Samin12665/MM-SIDE/out/reports/interference.md

# Interference and motion study

_Generated by `cad/build.py --check`._

## Static (ride height, straight ahead)

- No interference > 1 mm³.

## Motion sweep (steering × front travel, rear travel)

| Steer (crank frac) | Front travel L/R | Rear travel L/R | ψL | ψR | Collisions |
|---|---|---|---:|---:|---|
| -1 | -12/-12 | -12/-12 | -19.5° | -25.9° | 110_WHEEL_FL∩110_TIE_ROD_FL 1 mm³ |
| -1 | +18/+18 | +18/+18 | -19.2° | -25.9° | 110_WHEEL_FL∩110_TIE_ROD_FL 5 mm³ |
| -1 | +18/-12 | +18/-12 | -19.2° | -25.9° | 110_WHEEL_FL∩110_TIE_ROD_FL 5 mm³ |
| +0 | -12/-12 | -12/-12 | +0.0° | -0.0° | none |
| +0 | +18/+18 | +18/+18 | -0.0° | +0.0° | none |
| +0 | +18/-12 | +18/-12 | -0.0° | -0.0° | none |
| +1 | -12/-12 | -12/-12 | +25.9° | +19.5° | 110_WHEEL_FR∩110_TIE_ROD_FR 1 mm³ |
| +1 | +18/+18 | +18/+18 | +25.9° | +19.2° | 110_WHEEL_FR∩110_TIE_ROD_FR 5 mm³ |
| +1 | +18/-12 | +18/-12 | +25.9° | +19.5° | 110_WHEEL_FR∩110_TIE_ROD_FR 1 mm³ |
