Samin12665/MM-SIDE/docs/04_engineering_calculations.md

# 04 — Preliminary Engineering Calculations

_Generated by `analysis/vehicle_calcs.py` from `cad/master/car_master.py`. Do not edit by hand._

## 4.1 Mass and centre of gravity

Printed-part masses are taken from the CAD volumes (`out/reports/part_volumes.json`) × material density × effective fill (walls + infill). Purchased masses are vendor typicals.

| Item | Mass (kg) | X | Y | Z |
|---|---:|---:|---:|---:|
| Rear gearmotors x2 | 0.430 | -150 | 0 | 42 |
| Battery 3S 5000 | 0.380 | 30 | 0 | 49 |
| Jetson Orin Nano dev kit | 0.250 | -20 | 0 | 114 |
| Depth camera D435i | 0.072 | 172 | 0 | 140 |
| Main camera | 0.004 | 178 | 0 | 168 |
| LiDAR A1M8 (optional) | 0.170 | -40 | 0 | 218 |
| Steering servo | 0.060 | 208 | 0 | 36 |
| Wheels+tyres x4 | 0.280 | 0 | 0 | 42 |
| Shocks x4 | 0.080 | 0 | 0 | 80 |
| Motor driver | 0.060 | 60 | 40 | 78 |
| DC-DC converters x3 | 0.085 | 60 | -40 | 78 |
| MCU + IMU + receiver | 0.045 | 0 | 0 | 102 |
| E-stop + fuses + switch | 0.090 | -90 | 0 | 110 |
| Wiring + connectors | 0.150 | 20 | 0 | 70 |
| Al longerons x2 | 0.046 | 10 | 0 | 77 |
| Fasteners, bearings, inserts | 0.160 | 20 | 0 | 55 |
| Printed 10_MAIN_CHASSIS (PETG-CF) | 0.282 | 2 | -0 | 44 |
| Printed 11_LOWER_SKID (PETG) | 0.053 | 0 | 0 | 26 |
| Printed 12_UPPER_ELECTRONICS_DECK (PETG) | 0.131 | 28 | -0 | 93 |
| Printed 61_BATTERY_DOOR_L (PETG) | 0.007 | 30 | 78 | 48 |
| Printed 61_BATTERY_DOOR_R (PETG) | 0.007 | 30 | -78 | 48 |
| Printed 20_FRONT_BULKHEAD (PA-CF) | 0.078 | 161 | -3 | 36 |
| Printed 24_FRONT_SHOCK_TOWER (PA-CF) | 0.054 | 142 | -0 | 72 |
| Printed 21_FRONT_KNUCKLE_L (PA-CF) | 0.003 | 152 | 109 | 42 |
| Printed 22_FRONT_KNUCKLE_R (PA-CF) | 0.003 | 152 | -109 | 42 |
| Printed 23_FRONT_LOWER_ARM_L (PA-CF) | 0.015 | 145 | 67 | 26 |
| Printed 23_FRONT_LOWER_ARM_R (PA-CF) | 0.015 | 145 | -67 | 26 |
| Printed 42_BELLCRANK_L (PA-CF) | 0.001 | 177 | 48 | 35 |
| Printed 42_BELLCRANK_R (PA-CF) | 0.001 | 177 | -48 | 35 |
| Printed 42_DRAG_LINK (PA-CF) | 0.002 | 162 | 0 | 45 |
| Printed 42_SERVO_LINK (PA-CF) | 0.001 | 175 | 0 | 48 |
| Printed 31_REAR_TRAILING_ARM_L (PA-CF) | 0.056 | -97 | 89 | 47 |
| Printed 31_REAR_TRAILING_ARM_R (PA-CF) | 0.056 | -97 | -89 | 47 |
| Printed 32_REAR_HEX_ADAPTER_L (PA-CF) | 0.002 | -150 | 114 | 42 |
| Printed 32_REAR_HEX_ADAPTER_R (PA-CF) | 0.002 | -150 | -114 | 42 |
| Printed 30_REAR_SHOCK_TOWER (PA-CF) | 0.079 | -104 | -0 | 107 |
| Printed 70_COMPUTE_MOUNT (PETG) | 0.027 | -14 | -0 | 98 |
| Printed 71_MOTOR_CONTROLLER_MOUNT (PETG) | 0.016 | -65 | 29 | 39 |
| Printed 72_POWER_MODULE_MOUNT (PETG) | 0.010 | -76 | -36 | 39 |
| Printed 73_FRONT_POWER_TRAY (PETG) | 0.015 | 82 | -0 | 39 |
| Printed 74_MCU_IMU_PLATE (PETG) | 0.032 | 92 | -3 | 99 |
| Printed 83_SENSOR_MAST (PETG-CF) | 0.044 | 157 | -0 | 150 |
| Printed 81_DEPTH_SENSOR_MOUNT (PETG) | 0.014 | 165 | 0 | 132 |
| Printed 80_CAMERA_MOUNT (PETG) | 0.002 | 167 | -0 | 170 |
| Printed 84_LIDAR_MAST (PETG-CF) | 0.062 | -41 | -0 | 168 |
| Printed 82_LIDAR_MOUNT (PETG) | 0.026 | -40 | 0 | 198 |
| Printed 90_FRONT_BUMPER (TPU) | 0.063 | 228 | -0 | 58 |
| Printed 91_REAR_BUMPER (TPU) | 0.071 | -232 | -0 | 64 |
| Printed 92_BODY_SIDE_SKIRT_L (PETG) | 0.012 | 23 | 80 | 97 |
| Printed 92_BODY_SIDE_SKIRT_R (PETG) | 0.012 | 23 | -80 | 97 |
| Printed 100_RAIL_CABLE_CLIP (PETG) | 0.001 | 0 | 71 | 80 |
| **Total (with LiDAR)** | **3.62** | **-3.9** | **-0.3** | **75.6** |

* Weight distribution front/rear: **49 / 51 %** (front corner 8.6 N, rear corner 9.1 N).
* CG height 76 mm; half-track 125 mm → static rollover threshold a_y = (T/2)/h = **1.65 g**. Tyre μ≈1.0 on concrete, so the car slides before it rolls.
* Design allowance: +15 % mass growth → 4.16 kg used for all load cases below.

## 4.2 Drivetrain (dual rear gearmotors, direct drive)

Motor: Pololu 37D 19:1 12 V with 64 CPR encoder (VERIFY datasheet: 530 rpm no-load, 8.5 kg·cm stall, 5.5 A stall at 12 V).

| Quantity | Value |
|---|---:|
| Wheel radius | 42.5 mm |
| No-load wheel speed at 11.1 V | 490 rpm |
| No-load vehicle speed | 2.18 m/s |
| Expected loaded top speed | **1.85 m/s (6.7 km/h)** |
| Stall torque per motor at 11.1 V | 0.77 N·m |
| Rolling resistance (Crr 0.03) | 1.22 N |
| Torque/motor for 2.0 m/s² on flat | 0.203 N·m (26 % stall) |
| Torque/motor to climb 15° | 0.250 N·m (33 % stall) |
| Traction-limited torque/rear wheel (μ 0.9) | 0.400 N·m |
| Encoder resolution at wheel | 64 × 19 = 1216 counts/rev → 0.220 mm/count |

Assessment: a 2 m/s top speed is deliberate — it keeps camera motion blur, LiDAR scan skew and stopping distance compatible with indoor SLAM and path-planning work. Hill climbing at 15° uses 33 % of stall torque, which is inside the gearmotor's intermittent envelope; continuous operation should stay below ~25 % stall. Traction limit (0.40 N·m) is below stall (0.77 N·m), so an uncontrolled full-throttle launch can spin the rear tyres and corrupt wheel odometry. Firmware must ramp-limit acceleration to ≤ 2 m/s² (0.20 N·m, 51 % of traction limit); the front AS5600 wheel encoders (non-driven wheels) provide an independent slip check.

Stopping distance from top speed at 3 m/s² (active braking by the H-bridge): **573 mm**.

Gearmotor output shaft (Ø6 mm D-shaft) under a 3 g bump: F = 31.4 N at 18 mm overhang → M = 565 N·mm, σ = 27 MPa (steel yield ≥ 350 MPa, SF > 9). Wheel hub is placed hard against the gearbox face to keep the overhang short.

## 4.3 Steering

* Layout: front-steer dual bellcranks on vertical M3 shoulder bolts, drag link, M3 turnbuckle tie rods (74.3 mm).
* Inner / outer lock: **26.0° / 19.5°** — Ackermann 102 % at lock, 91 % at mid-travel (100 % = ideal).
* Turning radius (rear-axle centre): **0.72 m**; kerb-to-kerb (outer front tyre) ≈ 1.02 m.
* Bump steer over -12…+18 mm: **0.02°** (tie-rod inner ball placed on the instant-centre line; hold crank height ±0.2 mm with shims).
* Static (parked) steering torque per kingpin, μ=1.0, r_eff = scrub 12 + patch 10 mm: 0.219 N·m.
* Required servo torque ≈ **0.44 N·m (4.5 kg·cm)**. Selected 20 kg·cm servo → safety factor **4.4**.
* Crank rotation to lock: 31.0° → servo throw ≈ ±28° (within standard ±45°).

## 4.4 Suspension

Shock: 1/10 oil shock, 80 mm extended, 22 mm stroke → usable 58…80 mm.

| Corner | Droop length | Ride length | Bump length | Stroke used | Motion ratio | In range |
|---|---:|---:|---:|---:|---:|---|
| Front | 76.6 | 69.5 | 59.4 | 17.2 | 0.57 | YES |
| Rear | 79.5 | 71.2 | 58.5 | 21.0 | 0.70 | YES |

* Front: corner mass 1.01 kg, target ride frequency 3.5 Hz → wheel rate 0.49 N/mm, **spring rate 1.49 N/mm** (MR 0.57), static sag 20.3 mm (set with preload collar so ride height = design).

* Rear: corner mass 1.07 kg, target ride frequency 3.5 Hz → wheel rate 0.52 N/mm, **spring rate 1.05 N/mm** (MR 0.70), static sag 20.3 mm (set with preload collar so ride height = design).

* Front camber change over full travel: -1.38° … -0.02°; half-track change ≤ 2.4 mm (low tyre scrub → clean odometry).
* Rear: trailing arm → zero camber and track change; wheelbase change at full bump 1.4 mm.

## 4.5 Structural load cases (per corner, design mass)

| Case | Front corner Fz (N) | Rear corner Fz (N) | Notes |
|---|---:|---:|---|
| Static | 9.9 | 10.5 | |
| Pothole / kerb drop (3 g) | 29.8 | 31.4 | |
| Drop from 300 mm onto tyres (≈5 g) | 49.7 | 52.3 | |

* Front lower arm, 5 g, load at ball 33 mm outboard of shock mount: M = 1639 N·mm, section 18×8 mm → σ = 8.5 MPa. PA-CF (Z-direction-free layup, printed flat) allowable ≈ 45 MPa → SF 5.3.
* Rear trailing arm, 5 g: M = 1883 N·mm at shock mount → σ = 1.3 MPa (beam 18×22 mm) → SF 34.7. Motor torque reaction (0.8 N·m stall) is carried by 6× M3 face bolts: shear per bolt 9 N.
* Chassis spine: 2 × 10×10×1 6063 tubes (I = 492 mm⁴ each) along the full tub (238 mm, rear-arm pivots → front bulkhead joint). Conservative case — whole 3 g vehicle load at mid-span on the rails alone, simply supported: deflection 0.51 mm, stress 37.0 MPa vs 6063-T5 yield 145 MPa. The 55 mm deep printed tub walls and the bolted deck act in parallel and carry most of this in practice.
* Front bulkhead is a cantilever off the tub front wall (6× M3 into inserts + flange bearing). A 5 g front-corner load on both sides (99 N) at ≈ 35 mm from the flange gives ≈ 3.5 N·m → ≈ 70 N tension in the upper bolt pair, far below the ≈ 800 N pull-out of an M3 insert in PETG-CF.
* Torsion is carried by the closed box formed by skid + tub walls + rails + upper deck (deck screwed at 8 points).

## 4.6 Power budget and runtime

| Load | Power (W) |
|---|---:|
| Jetson Orin Nano (MAXN Super, typical) | 15.0 |
| Drive motors (2 × 0.9 A avg @ 11.1 V) | 20.0 |
| Steering servo avg | 2.0 |
| D435i | 2.0 |
| RPLIDAR A1 | 2.5 |
| MCU, IMU, receiver, encoders | 1.0 |
| DC-DC losses (~10 %) | 4.0 |
| **Total** | **46.5** |

Usable energy 3S 5000 mAh at 80 % DoD = 44.4 Wh → runtime ≈ **57 min** mixed driving; ≈ 93 min parked (compute + sensors only).

Peak current: 2 × stall 5.1 A + servo 3 A + electronics 2.5 A ≈ 16 A → main fuse 15 A slow-blow, motor-branch fuse 10 A, compute branch 5 A. Wire: 14 AWG battery–fuse–E-stop, 18 AWG motor, 22–24 AWG signal.

## 4.7 Design targets vs results

| Requirement | Target | Result |
|---|---|---|
| Mass (incl. optional LiDAR) | ≤ 3.6 kg | 3.62 kg |
| Top speed | 1.5–2.5 m/s | 1.85 m/s |
| Turning radius | ≤ 0.8 m | 0.72 m |
| Ground clearance | ≥ 25 mm under main tub | 25 mm tub, 18 mm front bulkhead (static). At full front compression the bulkhead underside is the bump stop, as on most 1/10 cars; fit 3 mm internal shock spacers if ground contact is unwanted |
| Wheel travel | ≥ 25 mm | 30 mm |
| Rollover threshold | ≥ 1.2 g | 1.65 g |
| Runtime | ≥ 30 min | 57 min |
| Camera height | 120–200 mm | 168 mm |
