Samin12665/MM-SIDE/out/renders/ASM_CAR_COMPLETE_exploded.png

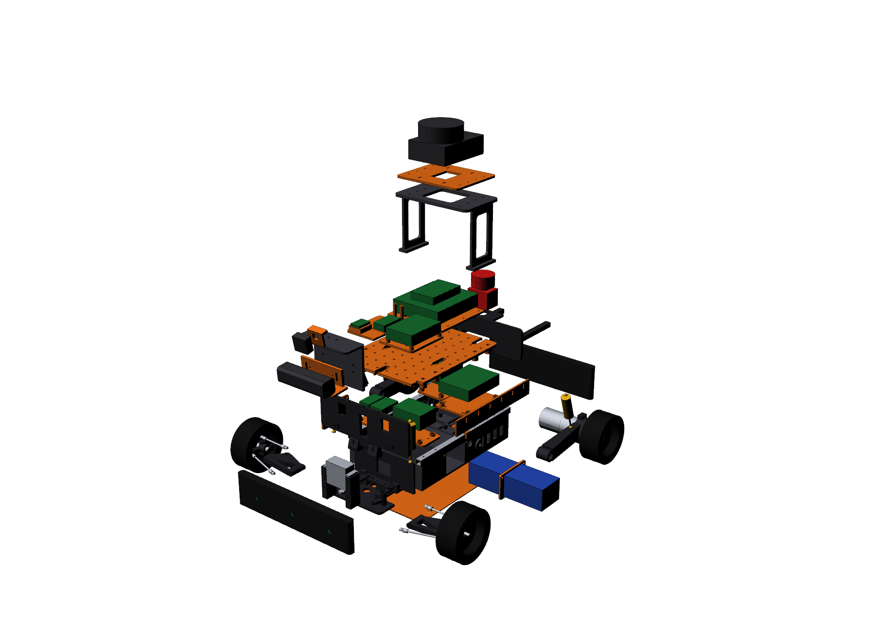
out/renders/ASM_CAR_COMPLETE_exploded.png
