Samin12665/MM-SIDE/out/renders/ASM_CAR_COMPLETE_iso_rear.png

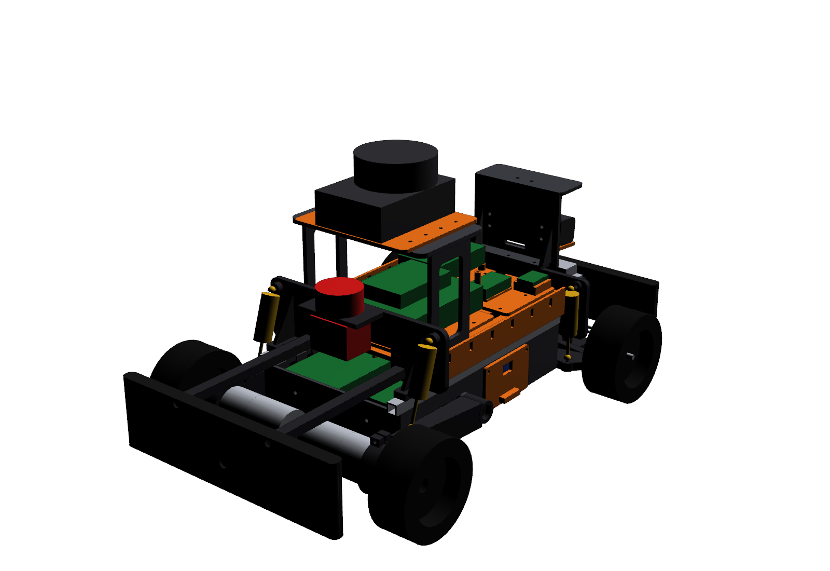
out/renders/ASM_CAR_COMPLETE_iso_rear.png
