Samin12665/MM-SIDE/out/renders/CHASSIS_LAYOUT_top.png

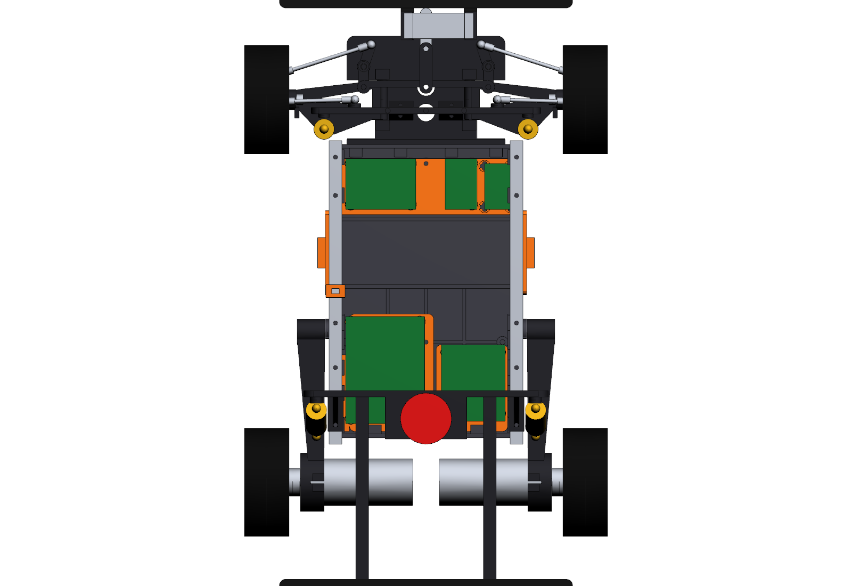
out/renders/CHASSIS_LAYOUT_top.png
