Samin12665/MM-SIDE/out/renders/FRONT_view.png

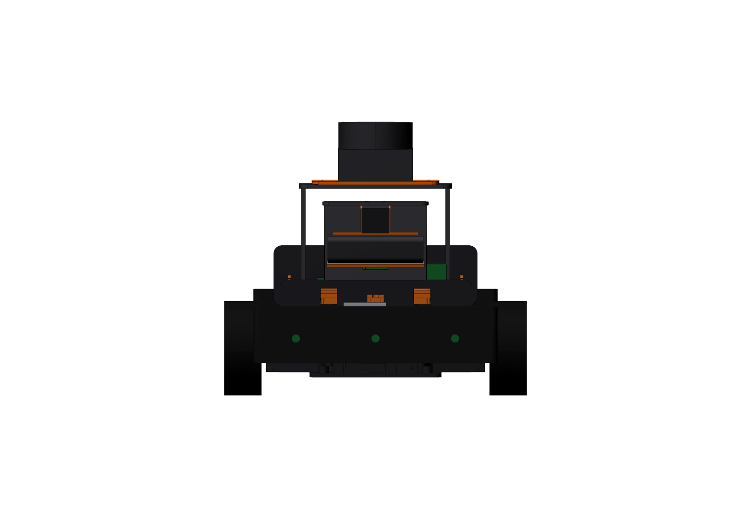
out/renders/FRONT_view.png
