Samin12665/MM-SIDE/out/renders/SENSOR_LAYOUT_side.png

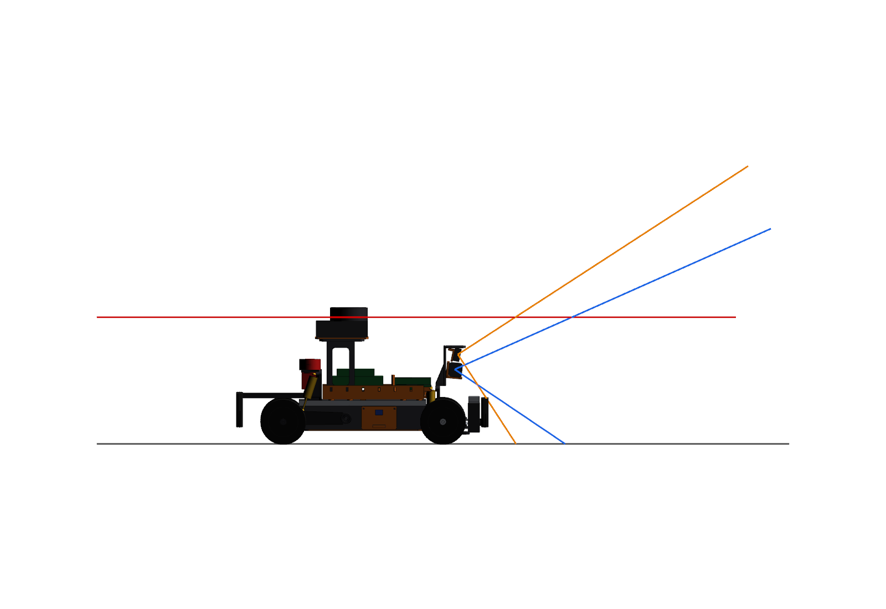
out/renders/SENSOR_LAYOUT_side.png
