Samin12665/MM-SIDE/out/renders/STEERING_full_lock_top.png

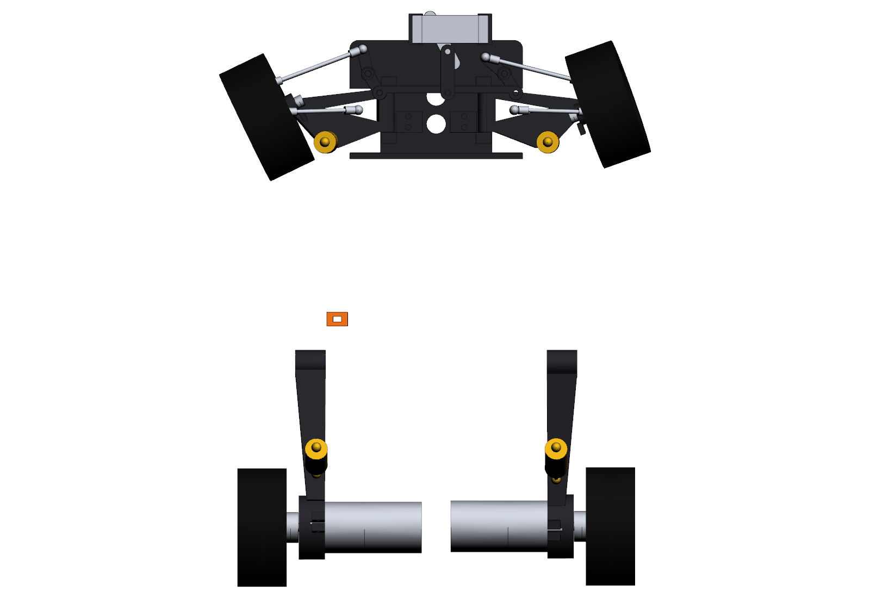
out/renders/STEERING_full_lock_top.png
