Samin12665/MM-SIDE/bom/print_list.csv

part | qty | material | orientation | layer_mm | walls | infill | top/bottom | supports | inserts | post_processing | print_bbox_mm | est_mass_g | stl
10_MAIN_CHASSIS | 1 | PETG-CF or ASA | floor on bed (as modelled); brim 5 mm | 0.20 | 4 | 30% gyroid | 5/5 | none | 38x M3 + 2x M5 | deburr; install heat-set inserts at 245 °C | 230.0x158.0x45.0 | 282 | out/stl/10_MAIN_CHASSIS.stl
11_LOWER_SKID | 1 | PETG | flat | 0.20 | 3 | 20% gyroid | 4/4 | none | — | install heat-set inserts at 240 °C | 226.0x144.0x2.0 | 53 | out/stl/11_LOWER_SKID.stl
12_UPPER_ELECTRONICS_DECK | 1 | PETG | top face on bed, ribs up | 0.20 | 3 | 20% gyroid | 4/4 | none | 24x M3 (fit only the grid nodes you use; 70 available) | install heat-set inserts at 240 °C | 208.0x160.0x14.0 | 131 | out/stl/12_UPPER_ELECTRONICS_DECK.stl
61_BATTERY_DOOR_L | 1 | PETG | outer face on bed | 0.20 | 3 | 20% gyroid | 4/4 | none | — | install heat-set inserts at 240 °C | 66.0x43.0x9.0 | 7 | out/stl/61_BATTERY_DOOR_L.stl
61_BATTERY_DOOR_R | 1 | PETG | outer face on bed | 0.20 | 3 | 20% gyroid | 4/4 | none | — | install heat-set inserts at 240 °C | 66.0x43.0x9.0 | 7 | out/stl/61_BATTERY_DOOR_R.stl
20_FRONT_BULKHEAD | 1 | PA-CF (PETG-CF acceptable) | floor on bed; supports only under servo-pillar insert bosses if the slicer flags them | 0.20 | 5 | 40% gyroid | 6/6 | none unless noted | 12x M3 | dry filament 8 h @ 80 °C before printing; anneal optional 80 °C 4 h; ream bearing seats, hinge holes Ø3.0/3.2 drill | 104.0x124.0x58.0 | 78 | out/stl/20_FRONT_BULKHEAD.stl
24_FRONT_SHOCK_TOWER | 1 | PA-CF | rear face on bed (plate flat) — layers in the load plane | 0.20 | 5 | 40% gyroid | 6/6 | none unless noted | 7x M3 | dry filament 8 h @ 80 °C before printing; anneal optional 80 °C 4 h; ream bearing seats, hinge holes Ø3.0/3.2 drill | 79.0x180.0x15.0 | 54 | out/stl/24_FRONT_SHOCK_TOWER.stl
21_FRONT_KNUCKLE_L | 1 | PA-CF | bearing axis vertical, inboard face on bed | 0.20 | 5 | 40% gyroid | 6/6 | none unless noted | 3x M3x4 short | dry filament 8 h @ 80 °C before printing; anneal optional 80 °C 4 h; ream bearing seats, hinge holes Ø3.0/3.2 drill | 39.4x22.3x19.6 | 3 | out/stl/21_FRONT_KNUCKLE_L.stl
22_FRONT_KNUCKLE_R | 1 | PA-CF | bearing axis vertical, inboard face on bed | 0.20 | 5 | 40% gyroid | 6/6 | none unless noted | 3x M3x4 short | dry filament 8 h @ 80 °C before printing; anneal optional 80 °C 4 h; ream bearing seats, hinge holes Ø3.0/3.2 drill | 39.4x22.3x19.6 | 3 | out/stl/22_FRONT_KNUCKLE_R.stl
23_FRONT_LOWER_ARM_L | 1 | PA-CF | flat (as modelled) | 0.20 | 5 | 40% gyroid | 6/6 | none unless noted | 2x M3 | dry filament 8 h @ 80 °C before printing; anneal optional 80 °C 4 h; ream bearing seats, hinge holes Ø3.0/3.2 drill | 44.5x73.3x8.6 | 15 | out/stl/23_FRONT_LOWER_ARM_L.stl
23_FRONT_LOWER_ARM_R | 1 | PA-CF | flat (as modelled) | 0.20 | 5 | 40% gyroid | 6/6 | none unless noted | 2x M3 | dry filament 8 h @ 80 °C before printing; anneal optional 80 °C 4 h; ream bearing seats, hinge holes Ø3.0/3.2 drill | 44.5x73.3x8.6 | 15 | out/stl/23_FRONT_LOWER_ARM_R.stl
42_BELLCRANK_L | 1 | PA-CF | flat, tie-rod arm down | 0.20 | 5 | 40% gyroid | 6/6 | none unless noted | 2x M3 | dry filament 8 h @ 80 °C before printing; anneal optional 80 °C 4 h; ream bearing seats, hinge holes Ø3.0/3.2 drill | 41.1x14.7x14.5 | 1 | out/stl/42_BELLCRANK_L.stl
42_BELLCRANK_R | 1 | PA-CF | flat, tie-rod arm down | 0.20 | 5 | 40% gyroid | 6/6 | none unless noted | 2x M3 | dry filament 8 h @ 80 °C before printing; anneal optional 80 °C 4 h; ream bearing seats, hinge holes Ø3.0/3.2 drill | 41.1x14.7x14.5 | 1 | out/stl/42_BELLCRANK_R.stl
42_DRAG_LINK | 1 | PA-CF | flat | 0.20 | 5 | 40% gyroid | 6/6 | none unless noted | 1x M3 | dry filament 8 h @ 80 °C before printing; anneal optional 80 °C 4 h; ream bearing seats, hinge holes Ø3.0/3.2 drill | 10.0x107.8x3.0 | 2 | out/stl/42_DRAG_LINK.stl
42_SERVO_LINK | 1 | PA-CF | flat | 0.20 | 5 | 40% gyroid | 6/6 | none unless noted | — | dry filament 8 h @ 80 °C before printing; anneal optional 80 °C 4 h; ream bearing seats, hinge holes Ø3.0/3.2 drill | 40.0x10.0x3.0 | 1 | out/stl/42_SERVO_LINK.stl
31_REAR_TRAILING_ARM_L | 1 | PA-CF | inboard face on bed: motor cup + pivot bores vertical, beam layers carry bending | 0.20 | 5 | 40% gyroid | 6/6 | none unless noted | 1x M3 | dry filament 8 h @ 80 °C before printing; anneal optional 80 °C 4 h; ream bearing seats, hinge holes Ø3.0/3.2 drill | 151.0x52.0x26.0 | 56 | out/stl/31_REAR_TRAILING_ARM_L.stl
31_REAR_TRAILING_ARM_R | 1 | PA-CF | inboard face on bed | 0.20 | 5 | 40% gyroid | 6/6 | none unless noted | 1x M3 | dry filament 8 h @ 80 °C before printing; anneal optional 80 °C 4 h; ream bearing seats, hinge holes Ø3.0/3.2 drill | 151.0x52.0x26.0 | 56 | out/stl/31_REAR_TRAILING_ARM_R.stl
32_REAR_HEX_ADAPTER_L | 1 | PA-CF | flange on bed | 0.20 | 5 | 40% gyroid | 6/6 | none unless noted | 1x M3x4 short | dry filament 8 h @ 80 °C before printing; anneal optional 80 °C 4 h; ream bearing seats, hinge holes Ø3.0/3.2 drill | 22.0x22.0x10.0 | 2 | out/stl/32_REAR_HEX_ADAPTER_L.stl
32_REAR_HEX_ADAPTER_R | 1 | PA-CF | flange on bed | 0.20 | 5 | 40% gyroid | 6/6 | none unless noted | 1x M3x4 short | dry filament 8 h @ 80 °C before printing; anneal optional 80 °C 4 h; ream bearing seats, hinge holes Ø3.0/3.2 drill | 22.0x22.0x10.0 | 2 | out/stl/32_REAR_HEX_ADAPTER_R.stl
30_REAR_SHOCK_TOWER | 1 | PA-CF (PETG-CF acceptable) | front face on bed (plate flat); tree supports under E-stop shelf + hoop arms | 0.20 | 5 | 40% gyroid | 6/6 | none unless noted | 4x M3 | dry filament 8 h @ 80 °C before printing; anneal optional 80 °C 4 h; ream bearing seats, hinge holes Ø3.0/3.2 drill | 56.2x192.0x148.0 | 79 | out/stl/30_REAR_SHOCK_TOWER.stl
70_COMPUTE_MOUNT | 1 | PETG | flat | 0.20 | 3 | 20% gyroid | 4/4 | none | — | install heat-set inserts at 240 °C | 112.0x112.0x9.0 | 27 | out/stl/70_COMPUTE_MOUNT.stl
71_MOTOR_CONTROLLER_MOUNT | 1 | PETG | flat | 0.20 | 3 | 20% gyroid | 4/4 | none | — | install heat-set inserts at 240 °C | 92.0x72.0x9.0 | 16 | out/stl/71_MOTOR_CONTROLLER_MOUNT.stl
72_POWER_MODULE_MOUNT | 1 | PETG | flat | 0.20 | 3 | 20% gyroid | 4/4 | none | — | install heat-set inserts at 240 °C | 68.0x56.0x9.0 | 10 | out/stl/72_POWER_MODULE_MOUNT.stl
73_FRONT_POWER_TRAY | 1 | PETG | flat | 0.20 | 3 | 20% gyroid | 4/4 | none | — | install heat-set inserts at 240 °C | 44.5x140.5x7.0 | 15 | out/stl/73_FRONT_POWER_TRAY.stl
74_MCU_IMU_PLATE | 1 | PETG | flat | 0.20 | 3 | 20% gyroid | 4/4 | none | — | install heat-set inserts at 240 °C | 78.0x132.0x33.0 | 32 | out/stl/74_MCU_IMU_PLATE.stl
83_SENSOR_MAST | 1 | PETG-CF | mast plate flat (back on bed) | 0.20 | 4 | 30% gyroid | 5/5 | none | 6x M3 | deburr; install heat-set inserts at 245 °C | 74.0x100.0x55.5 | 44 | out/stl/83_SENSOR_MAST.stl
81_DEPTH_SENSOR_MOUNT | 1 | PETG | mounting face on bed | 0.20 | 3 | 20% gyroid | 4/4 | none | — | install heat-set inserts at 240 °C | 32.5x92.0x30.1 | 14 | out/stl/81_DEPTH_SENSOR_MOUNT.stl
80_CAMERA_MOUNT | 1 | PETG | as modelled (support under arm) | 0.20 | 3 | 20% gyroid | 4/4 | none | — | install heat-set inserts at 240 °C | 12.6x28.0x25.0 | 2 | out/stl/80_CAMERA_MOUNT.stl
84_LIDAR_MAST | 1 | PETG-CF | top plate on bed, frames up | 0.20 | 4 | 30% gyroid | 5/5 | none | 8x M3 | deburr; install heat-set inserts at 245 °C | 84.0x152.0x101.0 | 62 | out/stl/84_LIDAR_MAST.stl
82_LIDAR_MOUNT | 1 | PETG | flat | 0.20 | 3 | 20% gyroid | 4/4 | none | — | install heat-set inserts at 240 °C | 100.0x120.0x3.0 | 26 | out/stl/82_LIDAR_MOUNT.stl
90_FRONT_BUMPER | 1 | TPU 95A | upright, webs vertical | 0.24 | 3 | 15% gyroid | 3/3 | none | — | print slow (25 mm/s); no inserts in TPU (screws pass through) | 16.0x230.0x53.0 | 63 | out/stl/90_FRONT_BUMPER.stl
91_REAR_BUMPER | 1 | TPU 95A | upright, webs vertical | 0.24 | 3 | 15% gyroid | 3/3 | none | — | print slow (25 mm/s); no inserts in TPU (screws pass through) | 12.0x230.0x63.0 | 71 | out/stl/91_REAR_BUMPER.stl
92_BODY_SIDE_SKIRT_L | 1 | PETG | outer face on bed | 0.20 | 3 | 20% gyroid | 4/4 | none | — | install heat-set inserts at 240 °C | 190.0x26.0x10.5 | 12 | out/stl/92_BODY_SIDE_SKIRT_L.stl
92_BODY_SIDE_SKIRT_R | 1 | PETG | outer face on bed | 0.20 | 3 | 20% gyroid | 4/4 | none | — | install heat-set inserts at 240 °C | 190.0x26.0x10.5 | 12 | out/stl/92_BODY_SIDE_SKIRT_R.stl
100_RAIL_CABLE_CLIP | 12 | PETG | saddle on bed | 0.20 | 3 | 20% gyroid | 4/4 | none | — | install heat-set inserts at 240 °C | 10.0x15.0x10.5 | 7 | out/stl/100_RAIL_CABLE_CLIP.stl
