Samin12665/MM-SIDE/out/step/ASM_SENSOR_SYSTEM.step

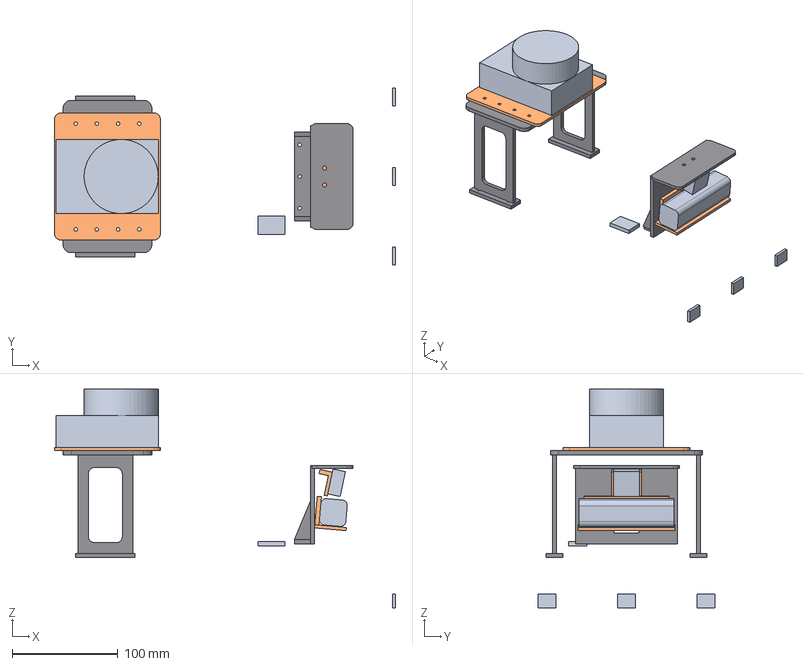
[picture p8: CAD file, 2026-09-28]
out/step/ASM_SENSOR_SYSTEM.step
322.0 x 167.0 x 206.5 mm
83_SENSOR_MAST
81_DEPTH_SENSOR_MOUNT
80_CAMERA_MOUNT
84_LIDAR_MAST
82_LIDAR_MOUNT
110_REALSENSE_D435I
110_CAMERA_IMX219
110_RPLIDAR_A1
110_IMU_BNO085
110_TOF_VL53L1X_0
110_TOF_VL53L1X_1
110_TOF_VL53L1X_2
