Samin12665/MM-SIDE/out/step/parts/10_MAIN_CHASSIS.step

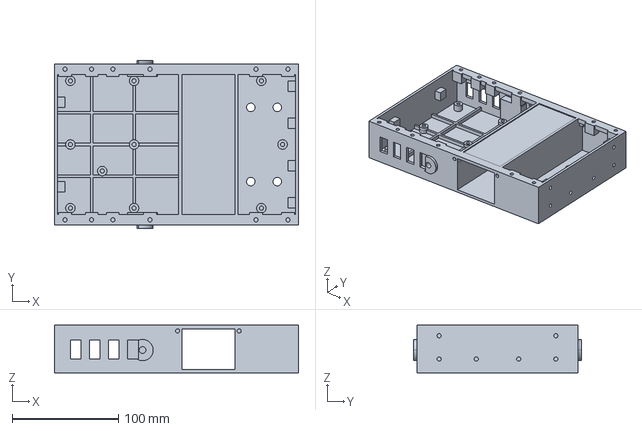
[picture p9: CAD file, 2026-09-28]
out/step/parts/10_MAIN_CHASSIS.step
230.0 x 158.0 x 45.0 mm
