Samin12665/MM-SIDE/out/step/ASM_REAR_SUSPENSION.step

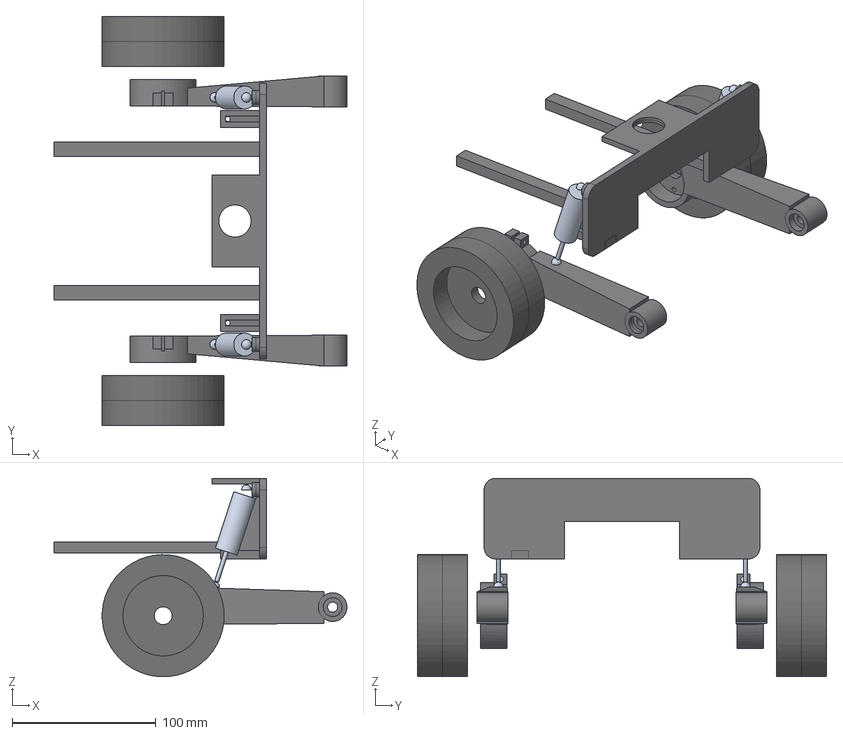
[picture p10: CAD file, 2026-09-28]
out/step/ASM_REAR_SUSPENSION.step
204.0 x 285.0 x 138.2 mm
30_REAR_SHOCK_TOWER
31_REAR_TRAILING_ARM_L
110_WHEEL_RL
110_SHOCK_RL
31_REAR_TRAILING_ARM_R
110_WHEEL_RR
110_SHOCK_RR
