Samin12665/MM-SIDE/out/step/ASM_CHASSIS.step

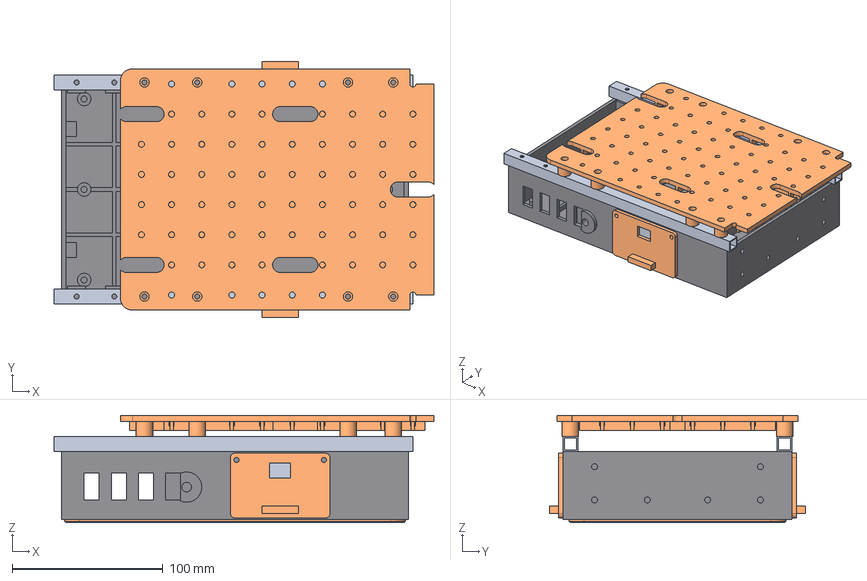
[picture p11: CAD file, 2026-09-28]
out/step/ASM_CHASSIS.step
252.0 x 170.0 x 71.0 mm
10_MAIN_CHASSIS
11_LOWER_SKID
12_UPPER_ELECTRONICS_DECK
61_BATTERY_DOOR_L
61_BATTERY_DOOR_R
110_BATTERY_3S_5000
110_AL_RAIL_10x10_L
110_AL_RAIL_10x10_R
