Samin12665/MM-SIDE/out/step/ASM_STEERING.step

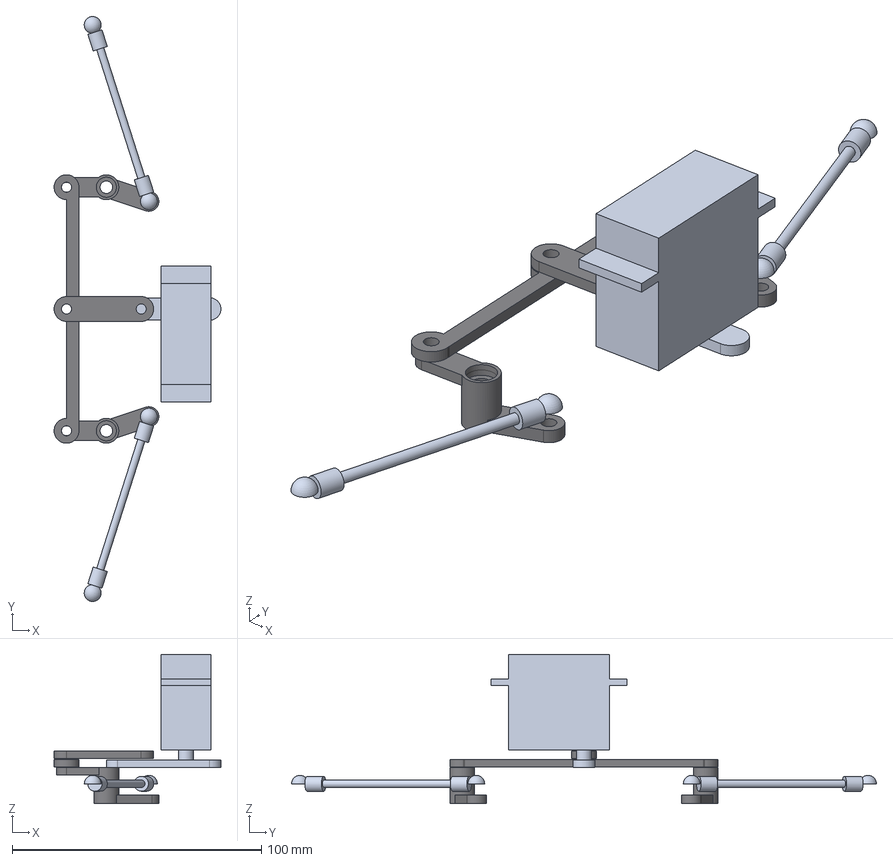
[picture p12: CAD file, 2026-09-28]
out/step/ASM_STEERING.step
67.0 x 234.9 x 60.0 mm
42_BELLCRANK_L
42_BELLCRANK_R
42_DRAG_LINK
42_SERVO_LINK
110_TIE_ROD_FL
110_TIE_ROD_FR
110_STEERING_SERVO
