Samin12665/MM-SIDE/out/step/ASM_CAR_COMPLETE.step

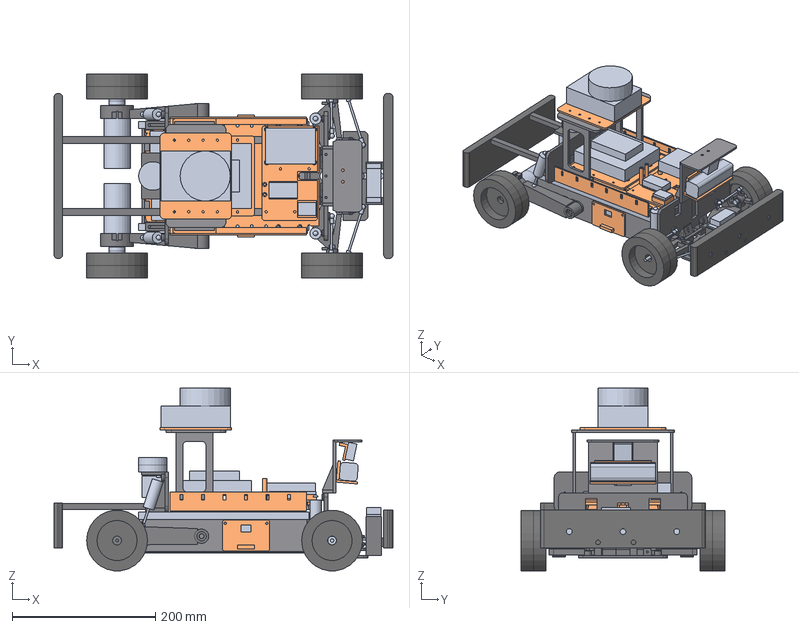
[picture p13: CAD file, 2026-09-28]
out/step/ASM_CAR_COMPLETE.step
473.0 x 285.0 x 254.7 mm
10_MAIN_CHASSIS
11_LOWER_SKID
12_UPPER_ELECTRONICS_DECK
61_BATTERY_DOOR_L
61_BATTERY_DOOR_R
20_FRONT_BULKHEAD
24_FRONT_SHOCK_TOWER
30_REAR_SHOCK_TOWER
70_COMPUTE_MOUNT
71_MOTOR_CONTROLLER_MOUNT
72_POWER_MODULE_MOUNT
73_FRONT_POWER_TRAY
74_MCU_IMU_PLATE
83_SENSOR_MAST
81_DEPTH_SENSOR_MOUNT
80_CAMERA_MOUNT
84_LIDAR_MAST
82_LIDAR_MOUNT
90_FRONT_BUMPER
91_REAR_BUMPER
92_BODY_SIDE_SKIRT_L
92_BODY_SIDE_SKIRT_R
100_RAIL_CABLE_CLIP
42_BELLCRANK_L
42_BELLCRANK_R
42_DRAG_LINK
42_SERVO_LINK
23_FRONT_LOWER_ARM_L
21_FRONT_KNUCKLE_L
110_WHEEL_FL
110_HEX12_FL
110_AXLE_M5x35_FL
110_BRG_685_FL1
110_BRG_685_FL2
110_SHOCK_FL
110_CAMBER_LINK_FL
110_TIE_ROD_FL
23_FRONT_LOWER_ARM_R
22_FRONT_KNUCKLE_R
110_WHEEL_FR
110_HEX12_FR
110_AXLE_M5x35_FR
110_BRG_685_FR1
110_BRG_685_FR2
110_SHOCK_FR
110_CAMBER_LINK_FR
110_TIE_ROD_FR
31_REAR_TRAILING_ARM_L
110_GEARMOTOR_37D_L
110_POLOLU_HUB_L
32_REAR_HEX_ADAPTER_L
110_WHEEL_RL
110_SHOCK_RL
31_REAR_TRAILING_ARM_R
110_GEARMOTOR_37D_R
110_POLOLU_HUB_R
32_REAR_HEX_ADAPTER_R
110_WHEEL_RR
110_SHOCK_RR
110_BATTERY_3S_5000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
