Samin12665/MM-SIDE/out/step/ASM_ELECTRONICS.step

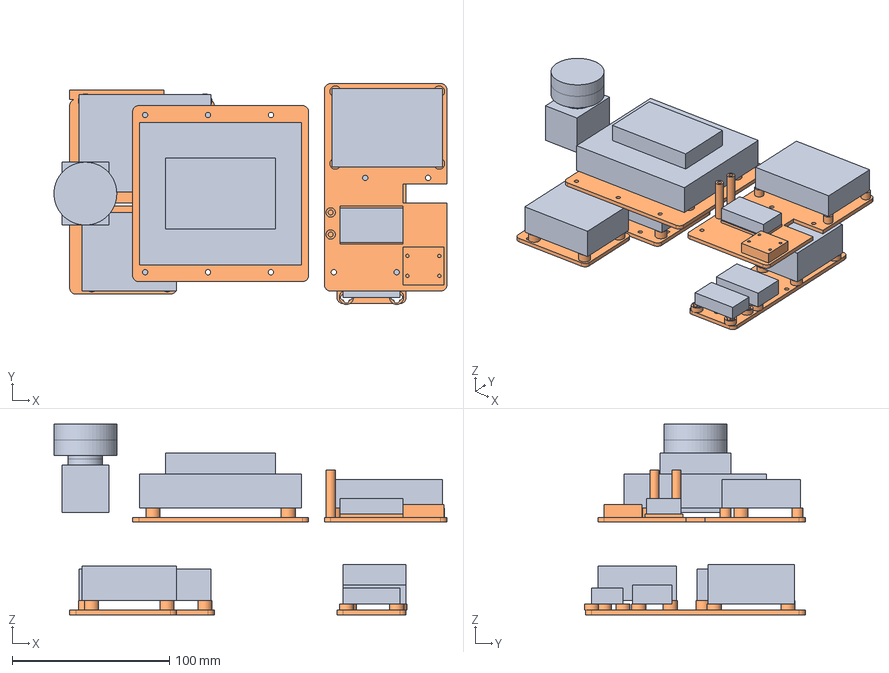
[picture p14: CAD file, 2026-09-28]
out/step/ASM_ELECTRONICS.step
250.0 x 140.5 x 121.2 mm
70_COMPUTE_MOUNT
71_MOTOR_CONTROLLER_MOUNT
72_POWER_MODULE_MOUNT
73_FRONT_POWER_TRAY
74_MCU_IMU_PLATE
110_JETSON_ORIN_NANO
110_ESTOP_22MM
110_MOTOR_DRIVER_MDD10A
110_DCDC_19V
110_FUSE_BLOCK
110_BEC_6V
110_BUCK_5V
110_TEENSY_CARRIER
110_RC_RECEIVER
