Samin12665/MM-SIDE/out/step/ASM_FRONT_SUSPENSION.step

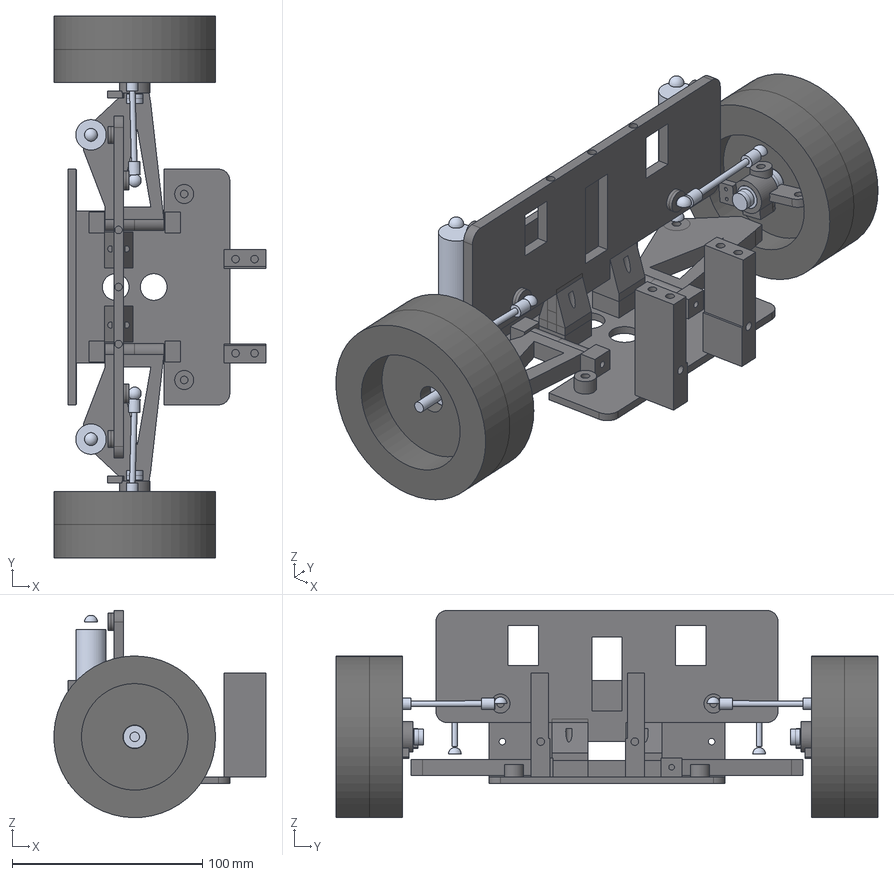
[picture p15: CAD file, 2026-09-28]
out/step/ASM_FRONT_SUSPENSION.step
111.4 x 285.0 x 109.0 mm
20_FRONT_BULKHEAD
24_FRONT_SHOCK_TOWER
23_FRONT_LOWER_ARM_L
21_FRONT_KNUCKLE_L
110_WHEEL_FL
110_HEX12_FL
110_AXLE_M5x35_FL
110_BRG_685_FL1
110_BRG_685_FL2
110_SHOCK_FL
110_CAMBER_LINK_FL
23_FRONT_LOWER_ARM_R
22_FRONT_KNUCKLE_R
110_WHEEL_FR
110_HEX12_FR
110_AXLE_M5x35_FR
110_BRG_685_FR1
110_BRG_685_FR2
110_SHOCK_FR
110_CAMBER_LINK_FR
