Samin12665/MM-SIDE/out/step/ASM_DRIVETRAIN.step

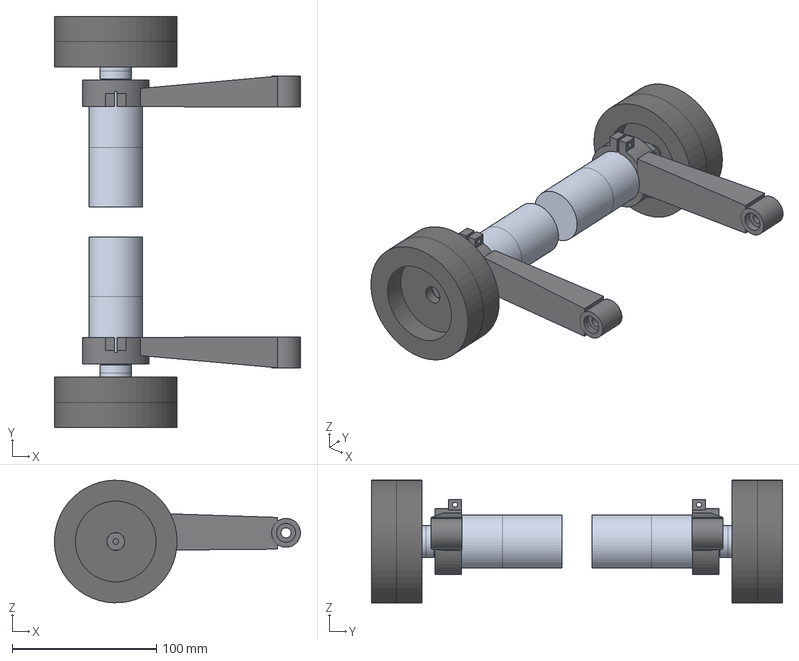
[picture p16: CAD file, 2026-09-28]
out/step/ASM_DRIVETRAIN.step
170.4 x 285.0 x 85.0 mm
31_REAR_TRAILING_ARM_L
110_GEARMOTOR_37D_L
110_POLOLU_HUB_L
32_REAR_HEX_ADAPTER_L
110_WHEEL_RL
31_REAR_TRAILING_ARM_R
110_GEARMOTOR_37D_R
110_POLOLU_HUB_R
32_REAR_HEX_ADAPTER_R
110_WHEEL_RR
