Samin12665/MM-SIDE/out/step/parts/81_DEPTH_SENSOR_MOUNT.step

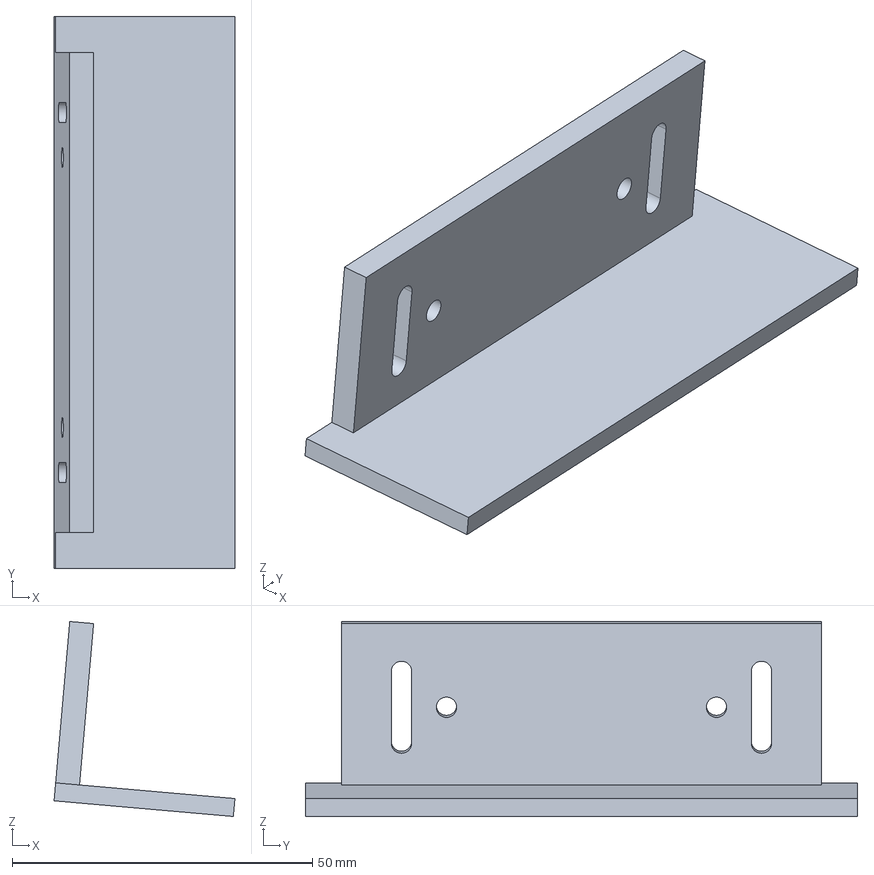
[picture p17: CAD file, 2026-09-28]
out/step/parts/81_DEPTH_SENSOR_MOUNT.step
30.1 x 92.0 x 32.5 mm
