Samin12665/MM-SIDE/out/step/parts/22_FRONT_CHUB_R.step

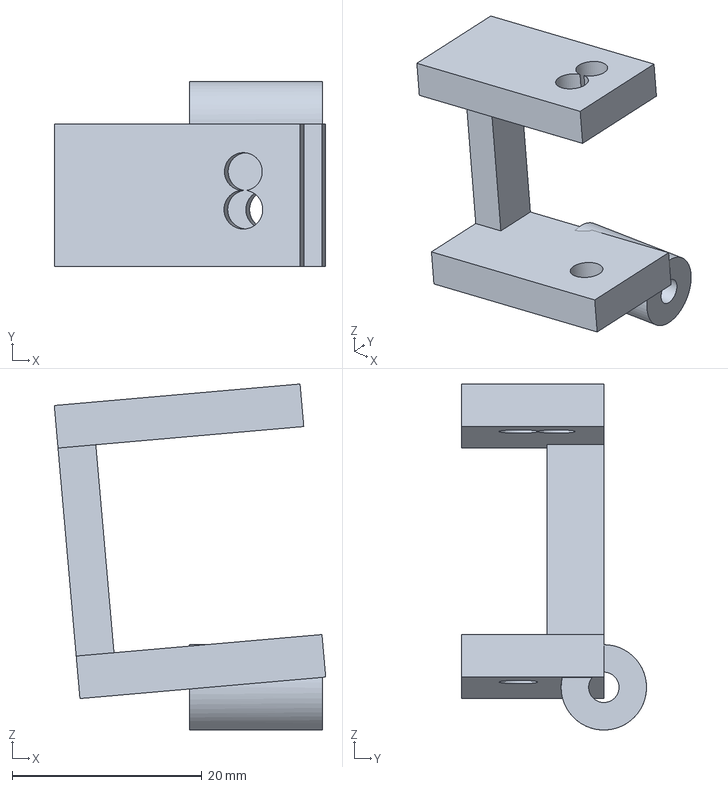
[picture p18: CAD file, 2026-09-28]
out/step/parts/22_FRONT_CHUB_R.step
28.6 x 19.5 x 36.5 mm
