Samin12665/MM-SIDE/out/step/parts/12_UPPER_ELECTRONICS_DECK.step

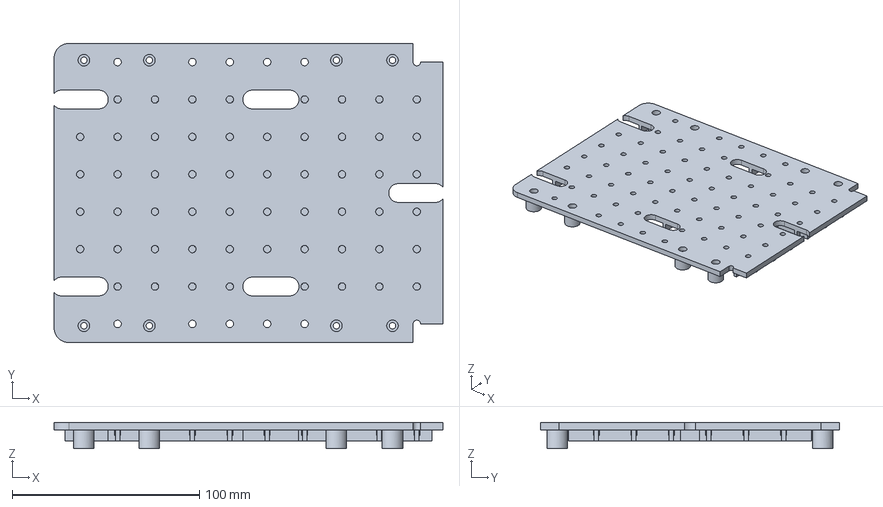
[picture p19: CAD file, 2026-09-28]
out/step/parts/12_UPPER_ELECTRONICS_DECK.step
208.0 x 160.0 x 14.0 mm
