Samin12665/MM-SIDE/out/step/parts/61_BATTERY_DOOR_R.step

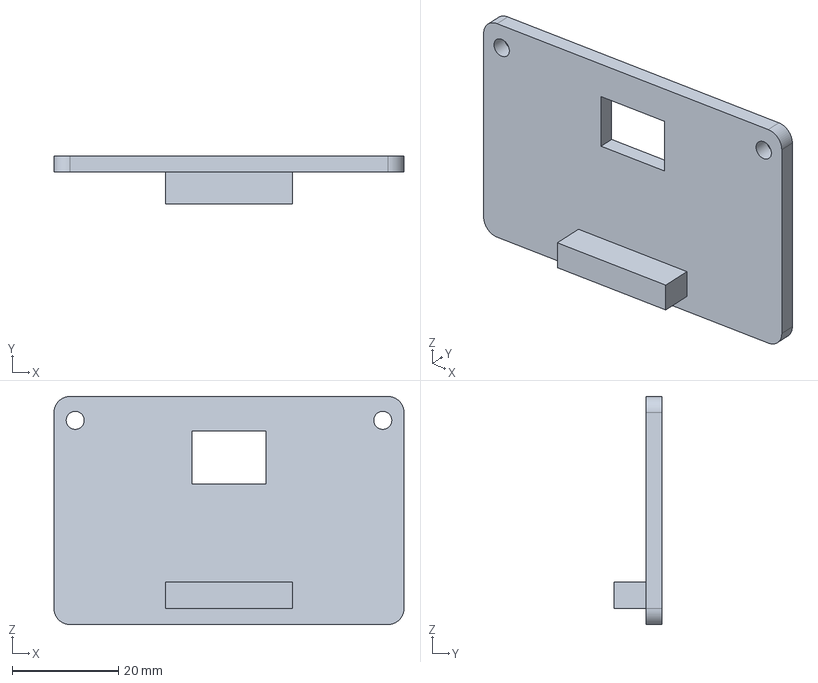
[picture p20: CAD file, 2026-09-28]
out/step/parts/61_BATTERY_DOOR_R.step
66.0 x 9.00 x 43.0 mm
