Samin12665/MM-SIDE/out/step/parts/82_LIDAR_MOUNT.step

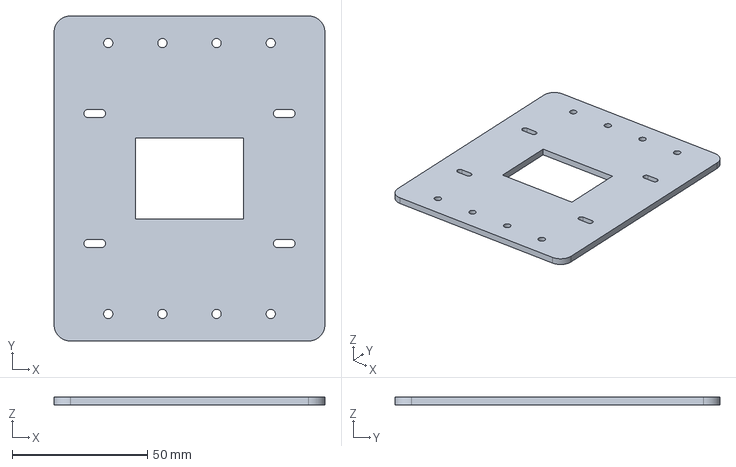
[picture p21: CAD file, 2026-09-28]
out/step/parts/82_LIDAR_MOUNT.step
100.0 x 120.0 x 3.00 mm
