Samin12665/MM-SIDE/out/step/parts/23_FRONT_LOWER_ARM_R.step

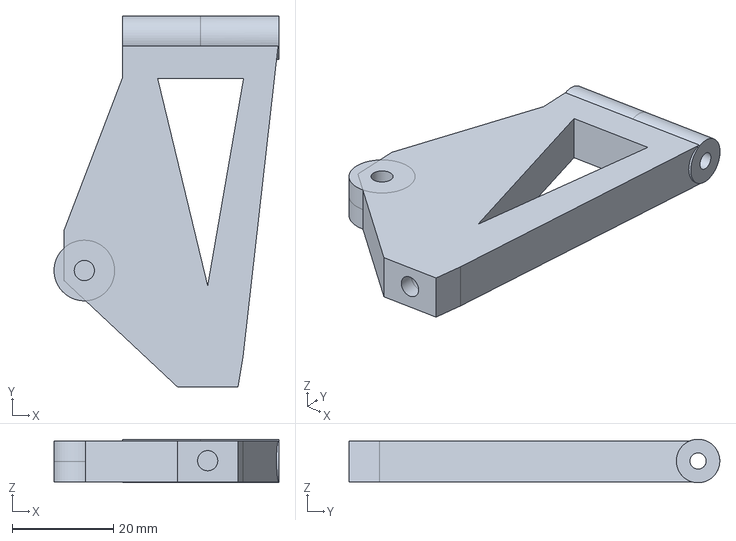
[picture p22: CAD file, 2026-09-28]
out/step/parts/23_FRONT_LOWER_ARM_R.step
44.5 x 73.3 x 8.60 mm
