Samin12665/MM-SIDE/out/step/parts/70_COMPUTE_MOUNT.step

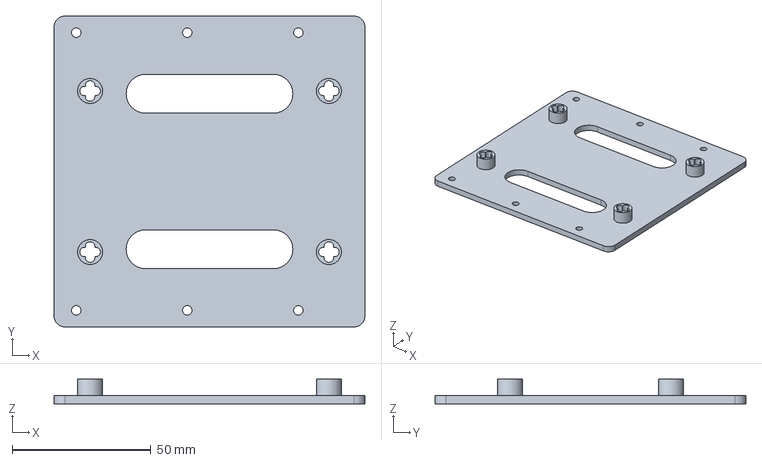
[picture p23: CAD file, 2026-09-28]
out/step/parts/70_COMPUTE_MOUNT.step
112.0 x 112.0 x 9.00 mm
