Samin12665/MM-SIDE/out/step/parts/32_REAR_HEX_ADAPTER_L.step

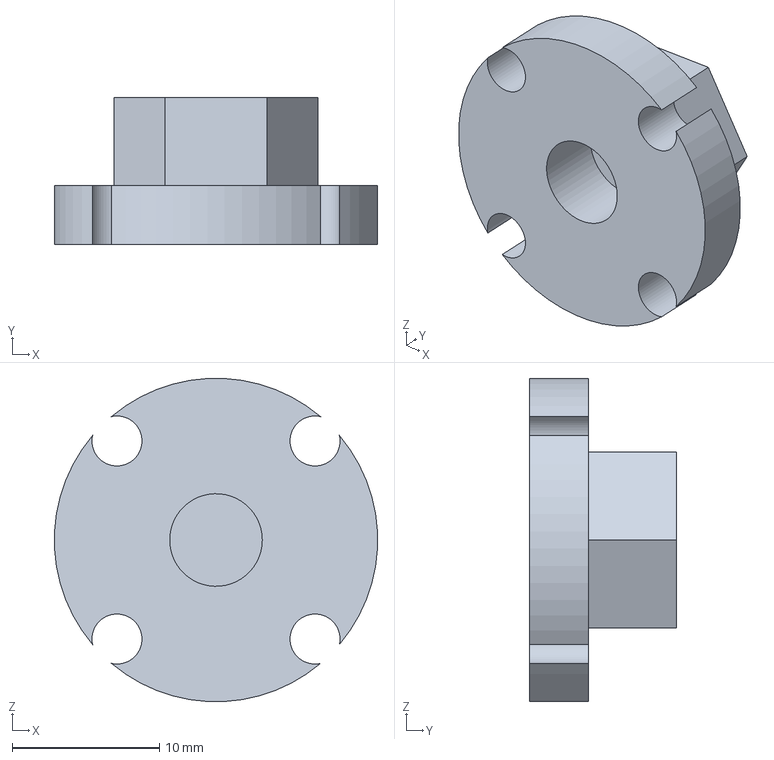
[picture p24: CAD file, 2026-09-28]
out/step/parts/32_REAR_HEX_ADAPTER_L.step
22.0 x 10.0 x 22.0 mm
