Samin12665/MM-SIDE/out/step/parts/42_DRAG_LINK.step

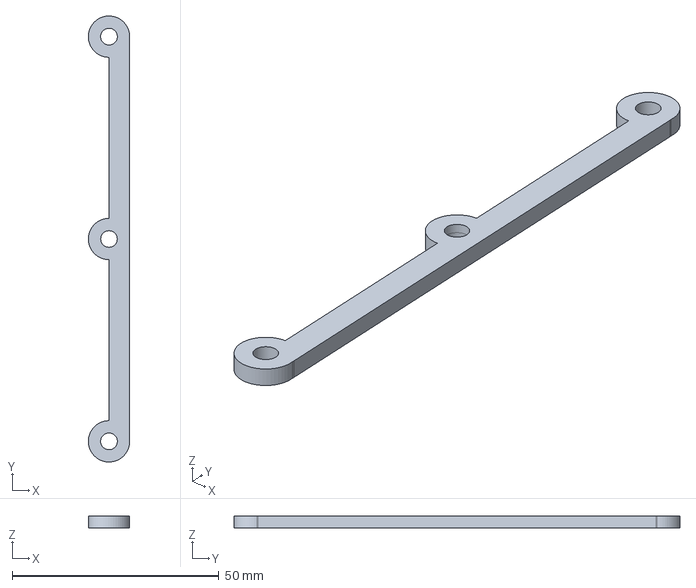
[picture p25: CAD file, 2026-09-28]
out/step/parts/42_DRAG_LINK.step
10.0 x 107.8 x 3.00 mm
