Samin12665/MM-SIDE/out/step/parts/100_RAIL_CABLE_CLIP.step

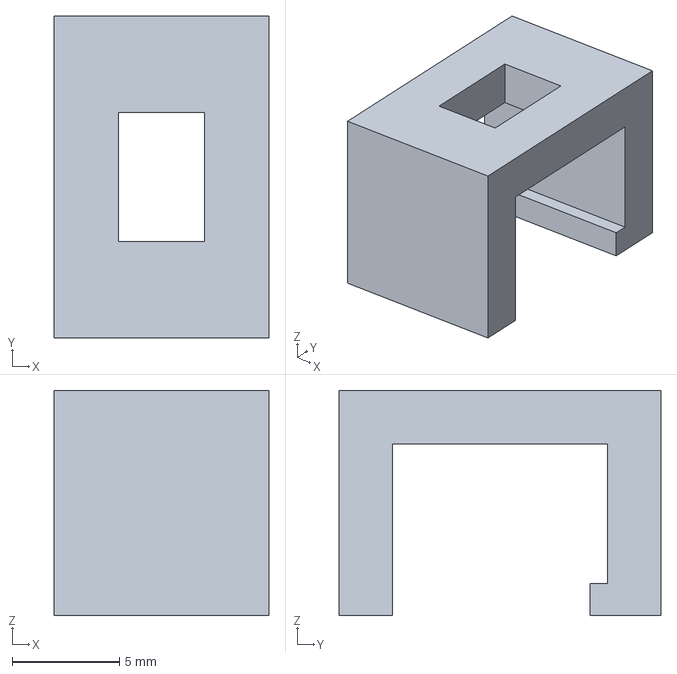
[picture p26: CAD file, 2026-09-28]
out/step/parts/100_RAIL_CABLE_CLIP.step
10.0 x 15.0 x 10.5 mm
