Samin12665/MM-SIDE/out/step/parts/72_POWER_MODULE_MOUNT.step

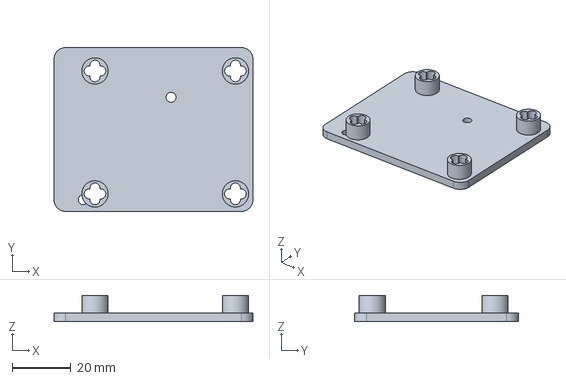
[picture p27: CAD file, 2026-09-28]
out/step/parts/72_POWER_MODULE_MOUNT.step
68.0 x 56.0 x 9.00 mm
