Samin12665/MM-SIDE/out/step/parts/71_MOTOR_CONTROLLER_MOUNT.step

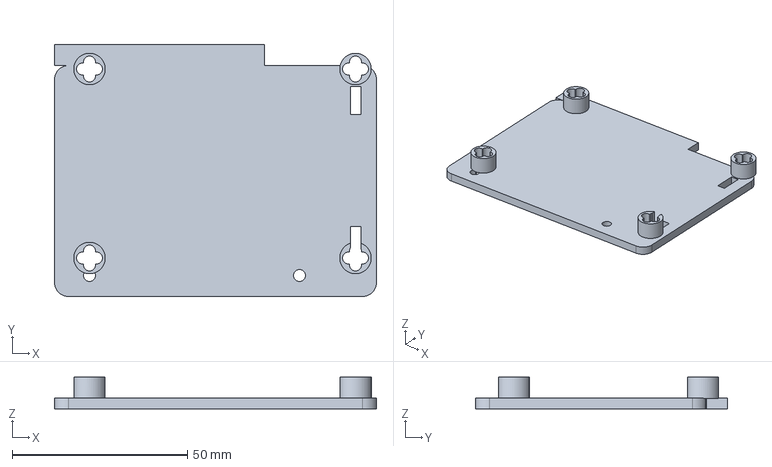
[picture p28: CAD file, 2026-09-28]
out/step/parts/71_MOTOR_CONTROLLER_MOUNT.step
92.0 x 72.0 x 9.00 mm
