Samin12665/MM-SIDE/out/step/parts/21_FRONT_KNUCKLE_L.step

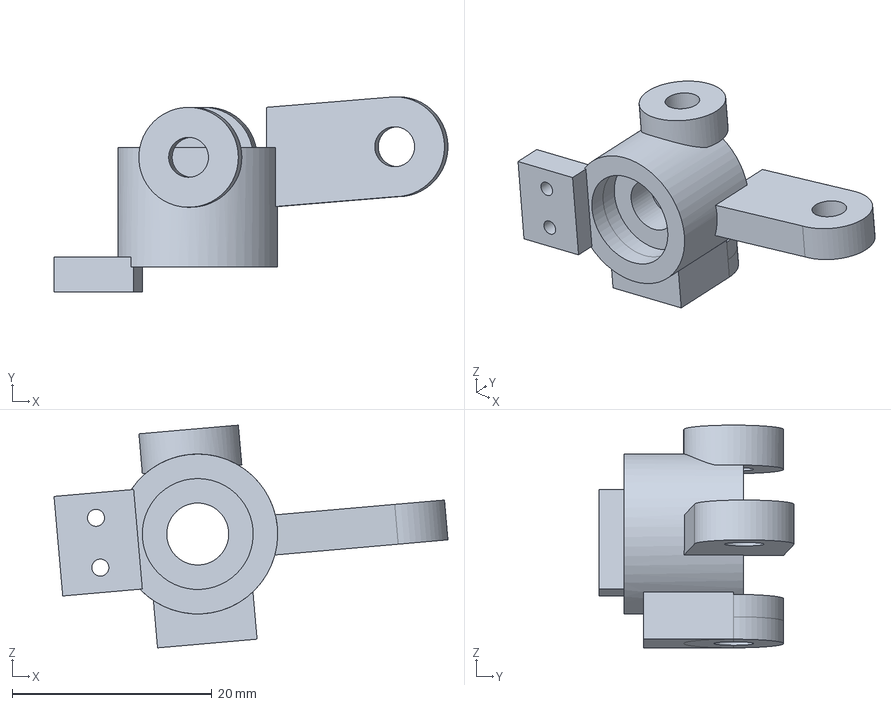
[picture p29: CAD file, 2026-09-28]
out/step/parts/21_FRONT_KNUCKLE_L.step
39.4 x 19.6 x 22.3 mm
