Samin12665/MM-SIDE/out/step/parts/92_BODY_SIDE_SKIRT_L.step

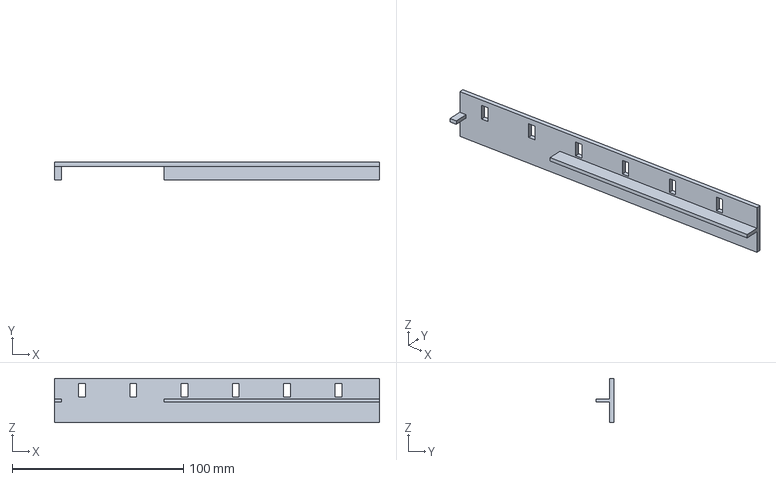
[picture p30: CAD file, 2026-09-28]
out/step/parts/92_BODY_SIDE_SKIRT_L.step
190.0 x 10.5 x 26.0 mm
