Samin12665/MM-SIDE/out/step/parts/91_REAR_BUMPER.step

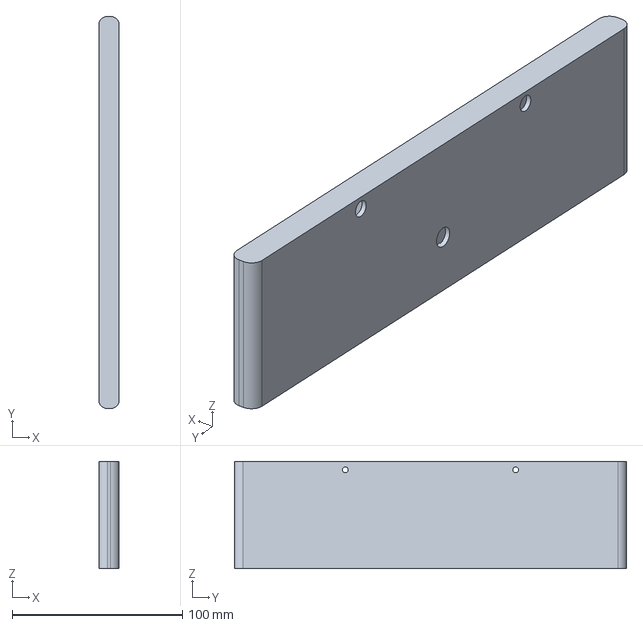
[picture p31: CAD file, 2026-09-28]
out/step/parts/91_REAR_BUMPER.step
12.0 x 230.0 x 63.0 mm
