Samin12665/MM-SIDE/out/step/parts/42_SERVO_LINK.step

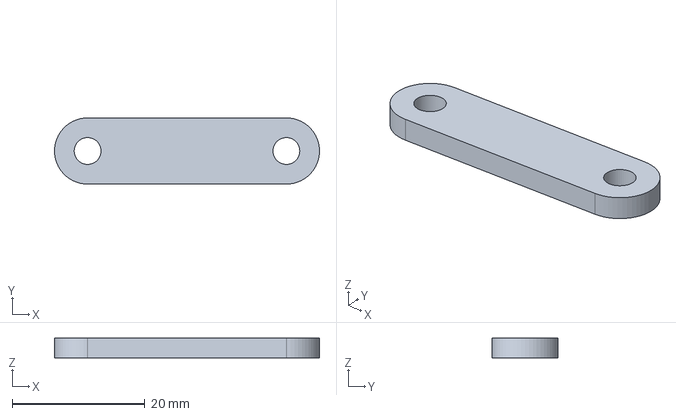
[picture p32: CAD file, 2026-09-28]
out/step/parts/42_SERVO_LINK.step
40.0 x 10.0 x 3.00 mm
