Samin12665/MM-SIDE/out/step/parts/31_REAR_TRAILING_ARM_L.step

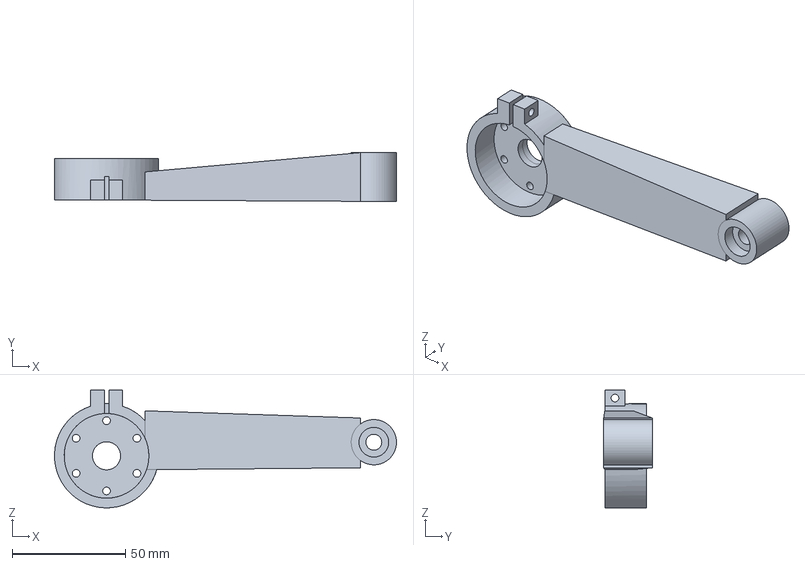
[picture p33: CAD file, 2026-09-28]
out/step/parts/31_REAR_TRAILING_ARM_L.step
151.0 x 21.5 x 52.0 mm
