Samin12665/MM-SIDE/out/step/parts/90_FRONT_BUMPER.step

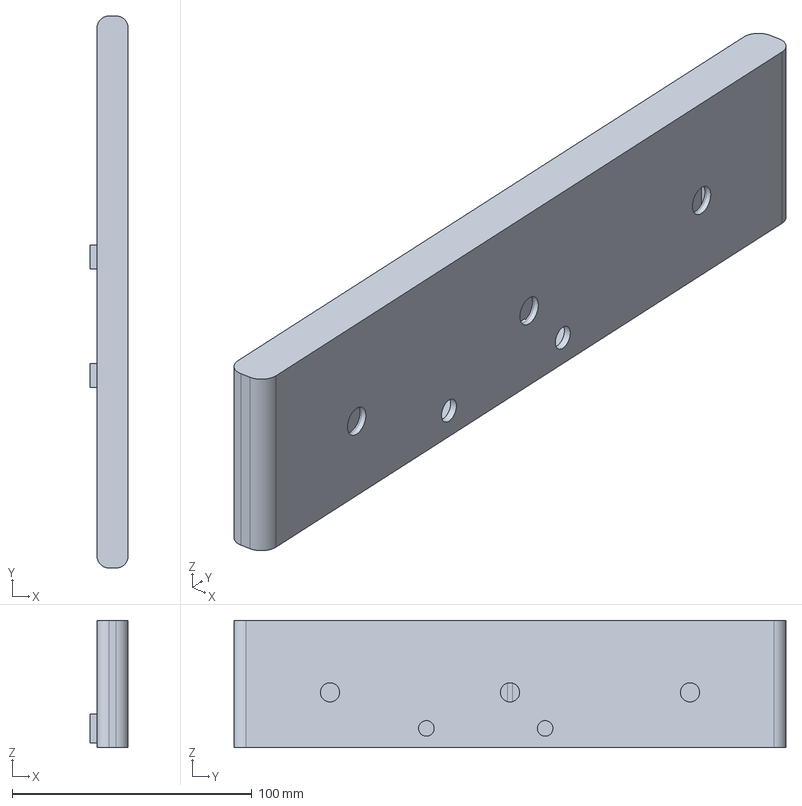
[picture p34: CAD file, 2026-09-28]
out/step/parts/90_FRONT_BUMPER.step
16.0 x 230.0 x 53.0 mm
