Samin12665/MM-SIDE/out/step/parts/73_FRONT_POWER_TRAY.step

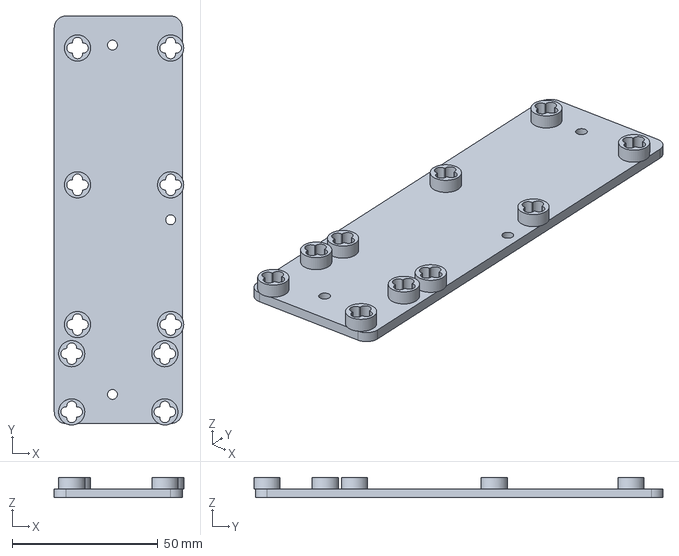
[picture p35: CAD file, 2026-09-28]
out/step/parts/73_FRONT_POWER_TRAY.step
44.5 x 140.5 x 7.00 mm
