Samin12665/MM-SIDE/out/step/parts/80_CAMERA_MOUNT.step

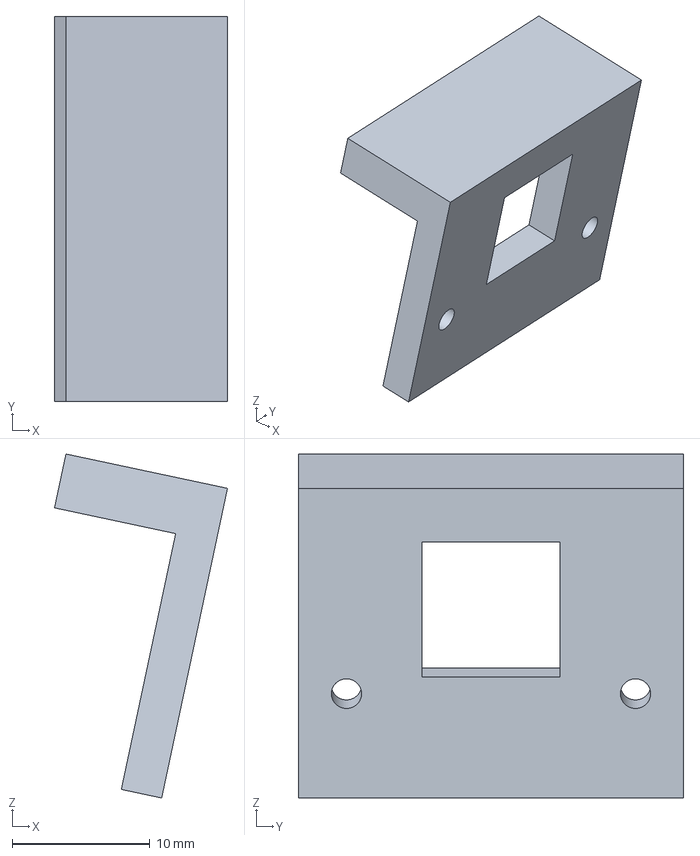
[picture p36: CAD file, 2026-09-28]
out/step/parts/80_CAMERA_MOUNT.step
12.6 x 28.0 x 25.0 mm
