Samin12665/MM-SIDE/out/step/parts/42_BELLCRANK_L.step

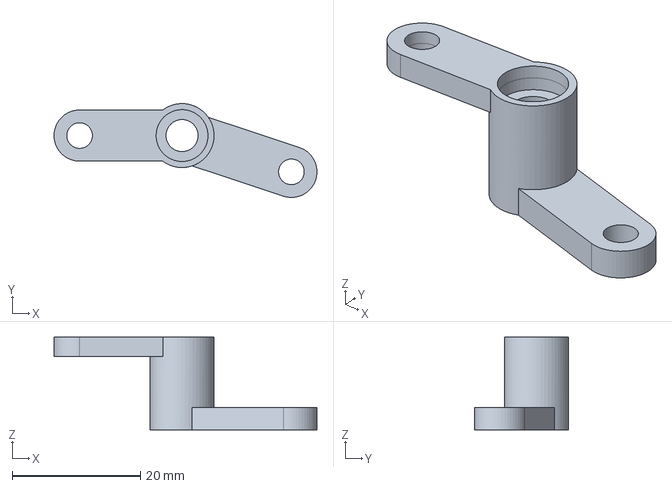
[picture p37: CAD file, 2026-09-28]
out/step/parts/42_BELLCRANK_L.step
41.1 x 14.7 x 14.5 mm
