Samin12665/MM-SIDE/out/step/parts/20_FRONT_BULKHEAD.step

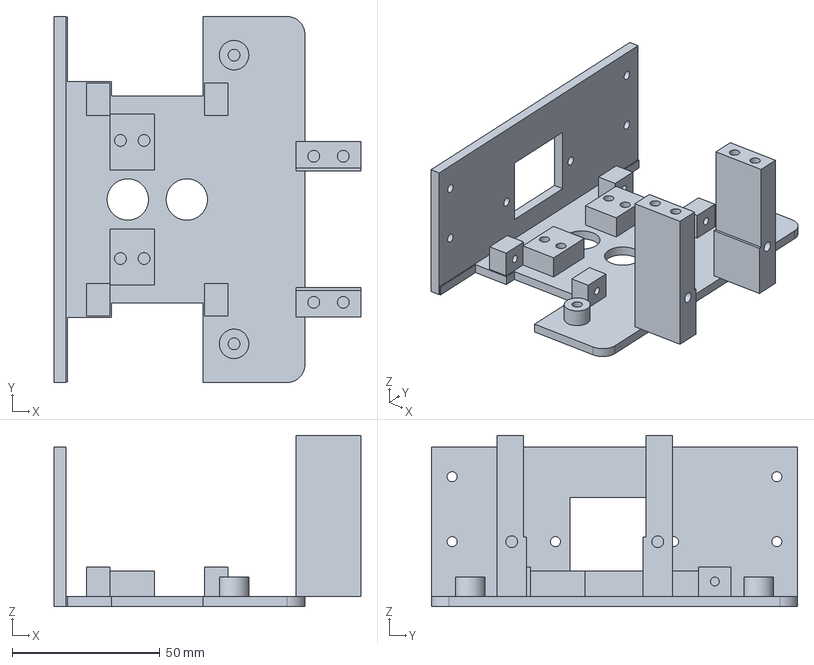
[picture p38: CAD file, 2026-09-28]
out/step/parts/20_FRONT_BULKHEAD.step
104.0 x 124.0 x 58.0 mm
