Samin12665/MM-SIDE/out/step/parts/24_FRONT_SHOCK_TOWER.step

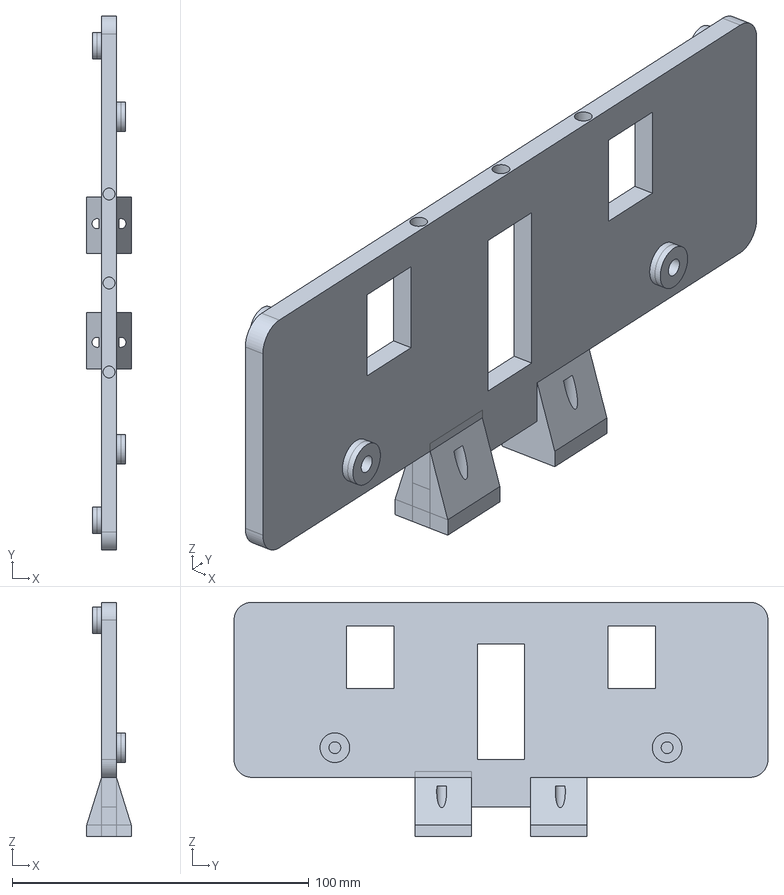
[picture p39: CAD file, 2026-09-28]
out/step/parts/24_FRONT_SHOCK_TOWER.step
15.0 x 180.0 x 79.0 mm
