Samin12665/MM-SIDE/out/step/parts/84_LIDAR_MAST.step

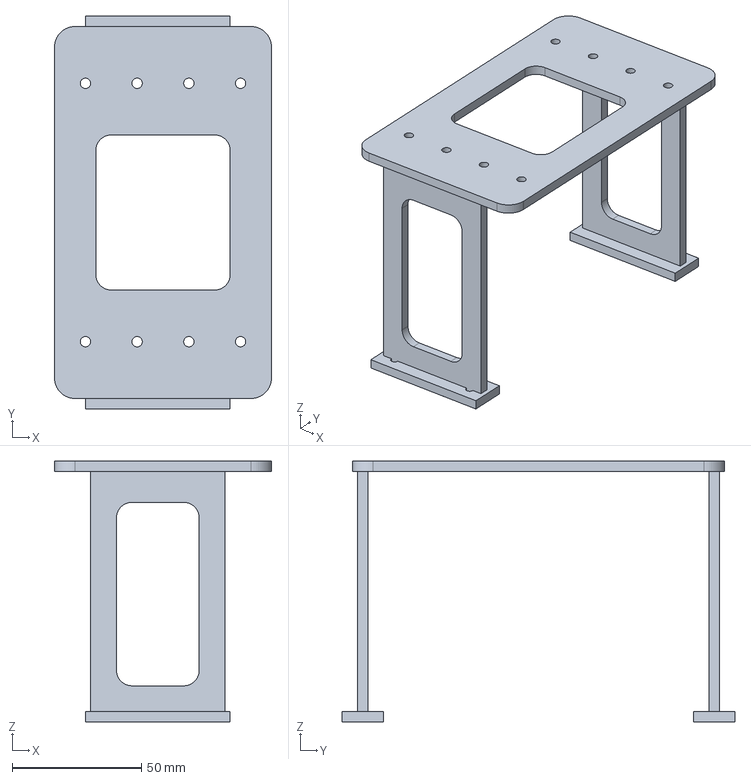
[picture p40: CAD file, 2026-09-28]
out/step/parts/84_LIDAR_MAST.step
84.0 x 152.0 x 101.0 mm
