Samin12665/MM-SIDE/out/step/parts/30_REAR_SHOCK_TOWER.step

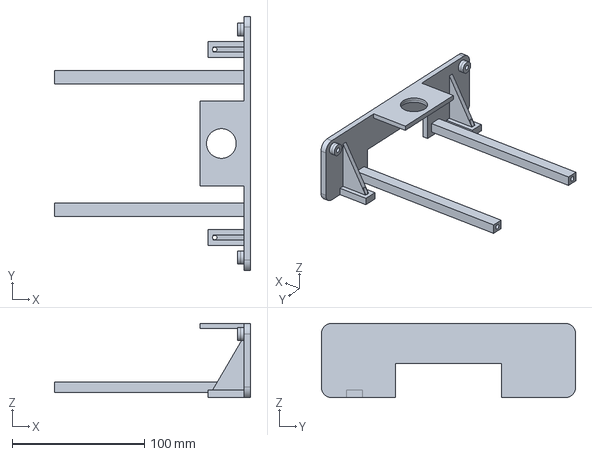
[picture p41: CAD file, 2026-09-28]
out/step/parts/30_REAR_SHOCK_TOWER.step
148.0 x 192.0 x 56.2 mm
