Samin12665/MM-SIDE/out/step/parts/74_MCU_IMU_PLATE.step

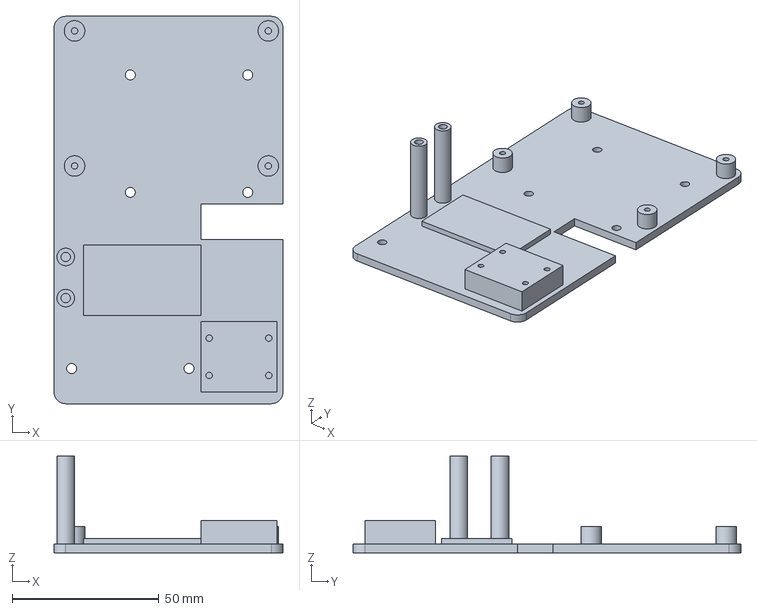
[picture p42: CAD file, 2026-09-28]
out/step/parts/74_MCU_IMU_PLATE.step
78.0 x 132.0 x 33.0 mm
