Samin12665/MM-SIDE/out/step/parts/83_SENSOR_MAST.step

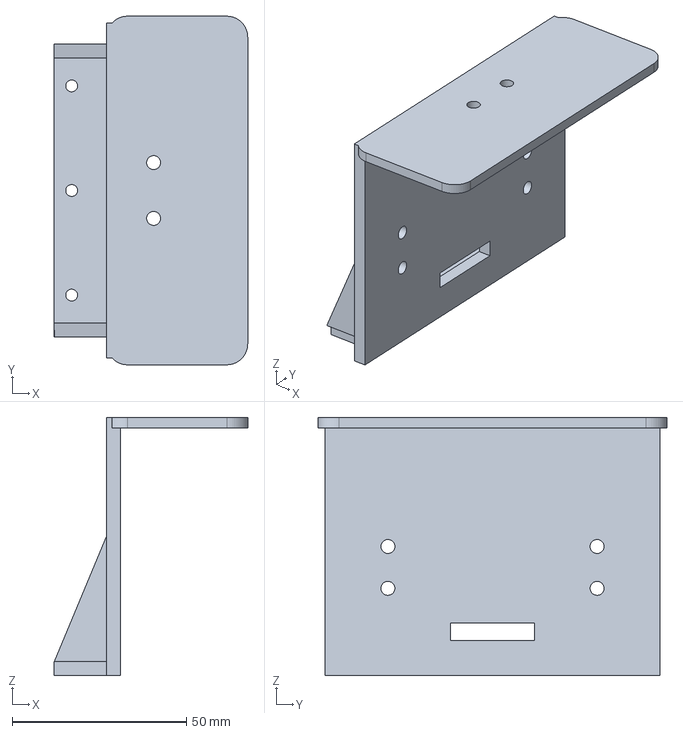
[picture p43: CAD file, 2026-09-28]
out/step/parts/83_SENSOR_MAST.step
55.5 x 100.0 x 74.0 mm
