Samin12665/MM-SIDE/out/step/parts/11_LOWER_SKID.step

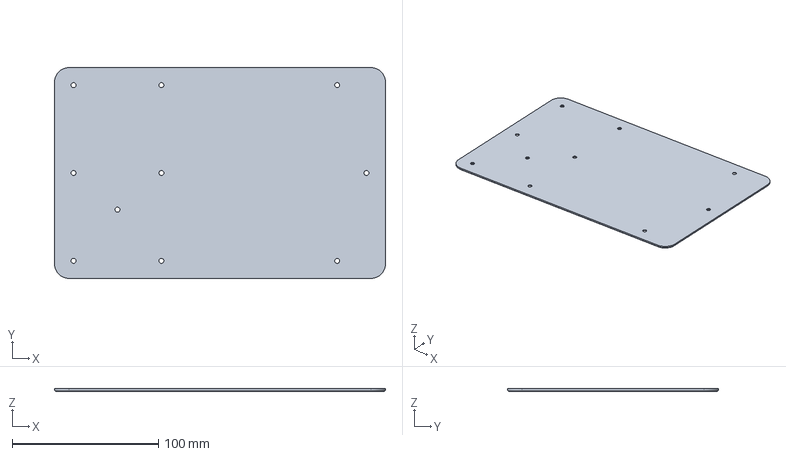
[picture p44: CAD file, 2026-09-28]
out/step/parts/11_LOWER_SKID.step
226.0 x 144.0 x 2.00 mm
