Samin12665/MM-SIDE/(list of files, cad)

Other CAD files:
out/step/parts/61_BATTERY_DOOR_L.step
out/step/parts/22_FRONT_KNUCKLE_R.step
out/step/parts/92_BODY_SIDE_SKIRT_R.step
out/step/parts/21_FRONT_CHUB_L.step
out/step/parts/32_REAR_HEX_ADAPTER_R.step
out/step/parts/23_FRONT_LOWER_ARM_L.step
out/step/parts/42_BELLCRANK_R.step
out/step/parts/31_REAR_TRAILING_ARM_R.step
out/stl/100_RAIL_CABLE_CLIP.stl
out/stl/10_MAIN_CHASSIS.stl
out/stl/11_LOWER_SKID.stl
out/stl/12_UPPER_ELECTRONICS_DECK.stl
out/stl/20_FRONT_BULKHEAD.stl
out/stl/21_FRONT_CHUB_L.stl
out/stl/21_FRONT_KNUCKLE_L.stl
out/stl/22_FRONT_CHUB_R.stl
out/stl/22_FRONT_KNUCKLE_R.stl
out/stl/23_FRONT_LOWER_ARM_L.stl
out/stl/23_FRONT_LOWER_ARM_R.stl
out/stl/24_FRONT_SHOCK_TOWER.stl
out/stl/30_REAR_SHOCK_TOWER.stl
out/stl/31_REAR_TRAILING_ARM_L.stl
out/stl/31_REAR_TRAILING_ARM_R.stl
out/stl/32_REAR_HEX_ADAPTER_L.stl
out/stl/32_REAR_HEX_ADAPTER_R.stl
out/stl/42_BELLCRANK_L.stl
out/stl/42_BELLCRANK_R.stl
out/stl/42_DRAG_LINK.stl
out/stl/42_SERVO_LINK.stl
out/stl/61_BATTERY_DOOR_L.stl
out/stl/61_BATTERY_DOOR_R.stl
out/stl/70_COMPUTE_MOUNT.stl
out/stl/71_MOTOR_CONTROLLER_MOUNT.stl
out/stl/72_POWER_MODULE_MOUNT.stl
out/stl/73_FRONT_POWER_TRAY.stl
out/stl/74_MCU_IMU_PLATE.stl
out/stl/80_CAMERA_MOUNT.stl
out/stl/81_DEPTH_SENSOR_MOUNT.stl
out/stl/82_LIDAR_MOUNT.stl
out/stl/83_SENSOR_MAST.stl
out/stl/84_LIDAR_MAST.stl
out/stl/90_FRONT_BUMPER.stl
out/stl/91_REAR_BUMPER.stl
out/stl/92_BODY_SIDE_SKIRT_L.stl
out/stl/92_BODY_SIDE_SKIRT_R.stl
