Samin12665/MM-SIDE/analysis/vehicle_calcs.py

"""
PHASE 4 preliminary vehicle engineering for ARV-1.
Reads CAR_MASTER, writes docs/04_engineering_calculations.md (tables regenerated
every run so the document never drifts from the model).
"""
import math, os, sys, json
import numpy as np
from scipy.optimize import brentq

HERE = os.path.dirname(os.path.abspath(__file__))
sys.path.insert(0, os.path.join(HERE, "..", "cad", "master"))
sys.path.insert(0, HERE)
import car_master as M
import front_kinematics as F

g = 9.81
out = []
w = out.append

# ---------------------------------------------------------------- mass & CG
# (name, mass kg, x, y, z)  positions in vehicle frame, mm
P = M.PURCHASED
items = [
    ("Rear gearmotors x2", 2 * P["motor"].mass, M.xRearAxle, 0, M.axleHeight),
    ("Battery 3S 5000", P["battery"].mass, M.batteryX, 0, M.batteryZ),
    ("Jetson Orin Nano dev kit", P["compute"].mass, -20, 0, M.electronicsDeckHeight + M.deckThickness + 18),
    ("Depth camera D435i", P["depth_cam"].mass, M.depthX, 0, M.depthZ),
    ("Main camera", P["camera"].mass, M.cameraX, 0, M.cameraZ),
    ("LiDAR A1M8 (optional)", P["lidar"].mass, M.lidarX, 0, M.lidarScanZ - 20),
    ("Steering servo", P["servo"].mass, M.servoX, 0, M.servoOutputZ - 10),
    ("Wheels+tyres x4", 4 * P["wheel"].mass, 0, 0, M.axleHeight),
    ("Shocks x4", 4 * P["shock"].mass, 0, 0, 80),
    ("Motor driver", P["motor_driver"].mass, 60, 40, M.electronicsDeckHeight - 14),
    ("DC-DC converters x3", 0.085, 60, -40, M.electronicsDeckHeight - 14),
    ("MCU + IMU + receiver", 0.045, 0, 0, M.electronicsDeckHeight + 10),
    ("E-stop + fuses + switch", 0.09, -90, 0, 110),
    ("Wiring + connectors", 0.15, 20, 0, 70),
    ("Al longerons x2", 2 * 0.036 * M.railLength / 1000 * 2.7 * 1000 / 1000 * 1.0, 10, 0, M.railZ),
    ("Printed chassis tub + skid", 0.330, 0, 0, M.floorZ + 20),
    ("Printed front bulkhead + steering", 0.120, 170, 0, 50),
    ("Printed front suspension (arms, C-hubs, knuckles)", 0.110, M.xFrontAxle, 0, 40),
    ("Printed rear trailing arms", 0.130, -95, 0, 48),
    ("Printed upper deck + mounts", 0.200, 0, 0, M.electronicsDeckHeight + 2),
    ("Printed sensor mast + mounts", 0.110, 90, 0, 150),
    ("Printed bumpers (TPU/PETG)", 0.120, 0, 0, 60),
    ("Fasteners, bearings, inserts", 0.160, 20, 0, 55),
]
# Replace the printed-part estimates with CAD-derived masses when the CAD has been built
_vol = os.path.join(HERE, "..", "out", "reports", "part_volumes.json")
CAD_MASS = os.path.exists(_vol)
if CAD_MASS:
    pv = json.load(open(_vol))
    items = [i for i in items if not i[0].startswith("Printed")]
    for n, d in pv.items():
        items.append((f"Printed {n} ({d['material'].split()[0]})", d["mass_g_printed"] / 1000, *d["centroid"]))
m_tot = sum(i[1] for i in items)
cg = np.array([sum(i[1] * i[k] for i in items) / m_tot for k in (2, 3, 4)])
front_frac = (cg[0] - M.xRearAxle) / M.wheelbase
W = m_tot * g
Wf_corner = W * front_frac / 2
Wr_corner = W * (1 - front_frac) / 2

w("# 04 — Preliminary Engineering Calculations\n")
w("_Generated by `analysis/vehicle_calcs.py` from `cad/master/car_master.py`. Do not edit by hand._\n")
w("## 4.1 Mass and centre of gravity\n")
w(("Printed-part masses are taken from the CAD volumes (`out/reports/part_volumes.json`) × material density × "
   "effective fill (walls + infill). " if CAD_MASS else "Printed-part masses are estimates (CAD not built yet). ") + "Purchased masses are vendor typicals.\n")
w("| Item | Mass (kg) | X | Y | Z |\n|---|---:|---:|---:|---:|")
for n, m, x, y, z in items:
    w(f"| {n} | {m:.3f} | {x:.0f} | {y:.0f} | {z:.0f} |")
w(f"| **Total (with LiDAR)** | **{m_tot:.2f}** | **{cg[0]:.1f}** | **{cg[1]:.1f}** | **{cg[2]:.1f}** |\n")
w(f"* Weight distribution front/rear: **{100*front_frac:.0f} / {100*(1-front_frac):.0f} %** "
  f"(front corner {Wf_corner:.1f} N, rear corner {Wr_corner:.1f} N).")
w(f"* CG height {cg[2]:.0f} mm; half-track {M.frontTrack/2:.0f} mm → static rollover threshold "
  f"a_y = (T/2)/h = **{M.frontTrack/2/cg[2]:.2f} g**. Tyre μ≈1.0 on concrete, so the car slides before it rolls.")
w(f"* Design allowance: +15 % mass growth → {1.15*m_tot:.2f} kg used for all load cases below.\n")
m_design = 1.15 * m_tot
W_d = m_design * g

# ---------------------------------------------------------------- drivetrain
rpm_nl = 530.0          # Pololu 37D 19:1 @12 V (VERIFY)
stall_Nm = 0.83         # 8.5 kg-cm
stall_A = 5.5
V_nom = 11.1
rw = M.wheelDiameter / 2 / 1000
rpm_nl_batt = rpm_nl * V_nom / 12.0
v_nl = rpm_nl_batt * 2 * math.pi / 60 * rw
v_loaded = 0.85 * v_nl
Crr = 0.03
F_roll = Crr * W_d
a_des = 2.0
slope = math.radians(15)
F_acc = m_design * a_des + F_roll
F_hill = W_d * math.sin(slope) + F_roll
T_acc = F_acc * rw / 2
T_hill = F_hill * rw / 2
stall_V = stall_Nm * V_nom / 12
T_trac = 0.9 * Wr_corner * 1.15 * rw   # traction-limited torque per rear wheel (μ 0.9)
w("## 4.2 Drivetrain (dual rear gearmotors, direct drive)\n")
w("Motor: Pololu 37D 19:1 12 V with 64 CPR encoder (VERIFY datasheet: 530 rpm no-load, 8.5 kg·cm stall, 5.5 A stall at 12 V).\n")
w("| Quantity | Value |\n|---|---:|")
w(f"| Wheel radius | {rw*1000:.1f} mm |")
w(f"| No-load wheel speed at 11.1 V | {rpm_nl_batt:.0f} rpm |")
w(f"| No-load vehicle speed | {v_nl:.2f} m/s |")
w(f"| Expected loaded top speed | **{v_loaded:.2f} m/s ({v_loaded*3.6:.1f} km/h)** |")
w(f"| Stall torque per motor at 11.1 V | {stall_V:.2f} N·m |")
w(f"| Rolling resistance (Crr 0.03) | {F_roll:.2f} N |")
w(f"| Torque/motor for {a_des} m/s² on flat | {T_acc:.3f} N·m ({100*T_acc/stall_V:.0f} % stall) |")
w(f"| Torque/motor to climb 15° | {T_hill:.3f} N·m ({100*T_hill/stall_V:.0f} % stall) |")
w(f"| Traction-limited torque/rear wheel (μ 0.9) | {T_trac:.3f} N·m |")
w(f"| Encoder resolution at wheel | 64 × 19 = {64*19} counts/rev → {2*math.pi*rw*1000/(64*19):.3f} mm/count |")
w("")
w(f"Assessment: a 2 m/s top speed is deliberate — it keeps camera motion blur, LiDAR "
  f"scan skew and stopping distance compatible with indoor SLAM and path-planning work. "
  f"Hill climbing at 15° uses {100*T_hill/stall_V:.0f}" " % of stall torque, which is inside the gearmotor's "
  "intermittent envelope; continuous operation should stay below ~25 % stall. "
  f"Traction limit ({T_trac:.2f} N·m) is below stall ({stall_V:.2f} N·m), so an uncontrolled full-throttle launch can spin the rear tyres "
  f"and corrupt wheel odometry. Firmware must ramp-limit acceleration to ≤ 2 m/s² ({T_acc:.2f} N·m, {100*T_acc/T_trac:.0f} % of traction limit); "
  "the front AS5600 wheel encoders (non-driven wheels) provide an independent slip check.\n")
stop_dist = v_loaded ** 2 / (2 * 3.0)
w(f"Stopping distance from top speed at 3 m/s² (active braking by the H-bridge): **{stop_dist*1000:.0f} mm**.\n")

# output shaft bending (motor carries wheel directly)
F_bump = 3.0 * Wr_corner * 1.15
overhang = 18.0
Mb = F_bump * overhang
Z = math.pi * 6 ** 3 / 32
w(f"Gearmotor output shaft (Ø6 mm D-shaft) under a 3 g bump: F = {F_bump:.1f} N at {overhang:.0f} mm overhang → "
  f"M = {Mb:.0f} N·mm, σ = {Mb/Z:.0f} MPa (steel yield ≥ 350 MPa, SF > 9). Wheel hub is placed hard against the gearbox face to keep the overhang short.\n")

# ---------------------------------------------------------------- steering
sol = json.load(open(os.path.join(HERE, "steering_solution.json")))
ack = sol["ackermann"]
di = ack[-1]["inner"]; do = ack[-1]["outer"]
R_rear_axle = M.wheelbase / math.tan(math.radians((di + do) / 2))
R_outer_wheel = math.hypot(M.wheelbase / math.tan(math.radians(do)) + M.frontTrack / 2, M.wheelbase) + 0
w("## 4.3 Steering\n")
w(f"* Layout: front-steer dual bellcranks on vertical M3 shoulder bolts, drag link, M3 turnbuckle tie rods ({M.tieRodLength:.1f} mm).")
w(f"* Inner / outer lock: **{di:.1f}° / {do:.1f}°** — Ackermann {ack[-1]['ackermann_pct']:.0f} % at lock, "
  f"{ack[4]['ackermann_pct']:.0f} % at mid-travel (100 % = ideal).")
w(f"* Turning radius (rear-axle centre): **{R_rear_axle/1000:.2f} m**; kerb-to-kerb (outer front tyre) ≈ {R_outer_wheel/1000:.2f} m.")
w(f"* Bump steer over {-M.droopTravel:.0f}…+{M.bumpTravel:.0f} mm: **{max(sol['bumpSteerDeg'])-min(sol['bumpSteerDeg']):.2f}°** "
  "(tie-rod inner ball placed on the instant-centre line; hold crank height ±0.2 mm with shims).")
Fz = Wf_corner * 1.15
mu = 1.0
r_eff = M.scrubRadius + 10.0
T_kp = mu * Fz * r_eff / 1000
arm = M.steeringArmLength / 1000
F_tie = T_kp / arm
T_crank = F_tie * M.crankRadius / 1000
F_drag = 2 * T_crank / (M.crankDragRadius / 1000)
T_servo = F_drag * (M.servoHornRadius / 1000) * 0.6   # servo link acts near-tangential; 0.6 geometric factor (conservative)
T_servo = max(T_servo, 2 * T_crank * M.servoHornRadius / M.crankDragRadius)
w(f"* Static (parked) steering torque per kingpin, μ=1.0, r_eff = scrub {M.scrubRadius:.0f} + patch 10 mm: {T_kp:.3f} N·m.")
w(f"* Required servo torque ≈ **{T_servo:.2f} N·m ({T_servo/0.0981:.1f} kg·cm)**. Selected 20 kg·cm servo → safety factor **{1.96/T_servo:.1f}**.")
w(f"* Crank rotation to lock: {sol['crankLockDeg']:.1f}° → servo throw ≈ ±{sol['crankLockDeg']*M.crankDragRadius/M.servoHornRadius:.0f}° (within standard ±45°).\n")

# ---------------------------------------------------------------- suspension
w("## 4.4 Suspension\n")
S_lo0 = np.array([M.frontShockLowerY, M.frontShockLowerZ])
up = np.array([M.frontShockUpperX - M.frontShockLowerX, M.frontShockUpperY, M.frontShockUpperZ])
fl = []
for tr in (-M.droopTravel, 0, M.bumpTravel):
    R2, t2, c, phi = F.corner(tr)
    p = F.I_L + F.rot2(phi) @ (S_lo0 - F.I_L)
    fl.append(float(np.linalg.norm(np.array([0, p[0], p[1]]) - up)))
piv = np.array([M.rearArmPivotX, M.rearArmPivotZ]); ax = np.array([M.xRearAxle, M.axleHeight])
sl = np.array([M.rearShockLowerX, M.rearShockLowerZ]); su = np.array([M.rearShockUpperX, M.rearShockUpperZ])
rot = lambda a: np.array([[math.cos(a), -math.sin(a)], [math.sin(a), math.cos(a)]])
rl = []
for tr in (-M.droopTravel, 0, M.bumpTravel):
    a = brentq(lambda a: (piv + rot(a) @ (ax - piv))[1] - (M.axleHeight + tr), -1, 1)
    rl.append(float(np.linalg.norm(piv + rot(a) @ (sl - piv) - su)))
ext, st = M.shockEyeToEyeExtended, M.shockStroke
w(f"Shock: 1/10 oil shock, {ext:.0f} mm extended, {st:.0f} mm stroke → usable {ext-st:.0f}…{ext:.0f} mm.\n")
w("| Corner | Droop length | Ride length | Bump length | Stroke used | Motion ratio | In range |\n|---|---:|---:|---:|---:|---:|---|")
for name, L in (("Front", fl), ("Rear", rl)):
    used = L[0] - L[2]
    mr = used / M.suspensionTravel
    ok = (L[0] <= ext + 0.01) and (L[2] >= ext - st - 0.01)
    w(f"| {name} | {L[0]:.1f} | {L[1]:.1f} | {L[2]:.1f} | {used:.1f} | {mr:.2f} | {'YES' if ok else '**NO**'} |")
mr_f = (fl[0] - fl[2]) / M.suspensionTravel
mr_r = (rl[0] - rl[2]) / M.suspensionTravel
f_target = 3.5
for name, Wc, mr in (("Front", Wf_corner * 1.15, mr_f), ("Rear", Wr_corner * 1.15, mr_r)):
    mc = Wc / g
    kw = mc * (2 * math.pi * f_target) ** 2 / 1000
    ks = kw / mr ** 2
    sag = Wc / (kw * 1000) * 1000
    w(f"\n* {name}: corner mass {mc:.2f} kg, target ride frequency {f_target} Hz → wheel rate {kw:.2f} N/mm, "
      f"**spring rate {ks:.2f} N/mm** (MR {mr:.2f}), static sag {sag:.1f} mm (set with preload collar so ride height = design).")
w("\n* Front camber change over full travel: "
  f"{min(s['camber'] for s in sol['suspension']):+.2f}° … {max(s['camber'] for s in sol['suspension']):+.2f}°; half-track change ≤ "
  f"{max(abs(s['trackChangeHalf']) for s in sol['suspension']):.1f} mm (low tyre scrub → clean odometry).")
w("* Rear: trailing arm → zero camber and track change; wheelbase change at full bump "
  f"{M.rearArmLength - math.sqrt(M.rearArmLength**2 - M.bumpTravel**2):.1f} mm.\n")

# ---------------------------------------------------------------- loads
w("## 4.5 Structural load cases (per corner, design mass)\n")
w("| Case | Front corner Fz (N) | Rear corner Fz (N) | Notes |\n|---|---:|---:|---|")
for case, k in (("Static", 1.0), ("Pothole / kerb drop (3 g)", 3.0), ("Drop from 300 mm onto tyres (≈5 g)", 5.0)):
    w(f"| {case} | {Wf_corner*1.15*k:.1f} | {Wr_corner*1.15*k:.1f} | |")
w("")
# lower arm bending at 5 g, PA-CF printed arm, section 18 x 8 mm near inner hinge
Fz5 = Wf_corner * 1.15 * 5
# shock carries load; arm sees bending between shock mount and ball. conservative: full load at arm tip, lever to shock mount
lever = M.kingpinY - M.frontShockLowerY
Mb = Fz5 * lever
b, h = 18.0, 8.0
sig = Mb / (b * h ** 2 / 6)
w(f"* Front lower arm, 5 g, load at ball {lever:.0f} mm outboard of shock mount: M = {Mb:.0f} N·mm, section 18×8 mm → σ = {sig:.1f} MPa. "
  f"PA-CF (Z-direction-free layup, printed flat) allowable ≈ 45 MPa → SF {45/sig:.1f}.")
# rear arm: shock at 30 mm from axle; arm beam 18 wide x 22 tall
Fz5r = Wr_corner * 1.15 * 5
Mr = Fz5r * (M.rearShockLowerX - M.xRearAxle)
sig_r = Mr / (18 * 22 ** 2 / 6)
w(f"* Rear trailing arm, 5 g: M = {Mr:.0f} N·mm at shock mount → σ = {sig_r:.1f} MPa (beam 18×22 mm) → SF {45/sig_r:.1f}. "
  "Motor torque reaction (0.8 N·m stall) is carried by 6× M3 face bolts: shear per bolt "
  f"{0.8/(0.0155*6):.0f} N.")
# chassis bending: two 10x10x1 Al rails + tub
I_rail = (10 ** 4 - 8 ** 4) / 12
EI = 2 * 69000 * I_rail
Lspan = M.railLength
Fmid = W_d * 3
defl = Fmid * Lspan ** 3 / (48 * EI)
w(f"* Chassis spine: 2 × 10×10×1 6063 tubes (I = {I_rail:.0f} mm⁴ each) along the full tub ({M.railLength:.0f} mm, rear-arm pivots → "
  f"front bulkhead joint). Conservative case — whole 3 g vehicle load at mid-span on the rails alone, simply supported: deflection "
  f"{defl:.2f} mm, stress {Fmid*Lspan/4*5/(2*I_rail):.1f} MPa vs 6063-T5 yield 145 MPa. The 55 mm deep printed tub walls and the "
  "bolted deck act in parallel and carry most of this in practice.")
w("* Front bulkhead is a cantilever off the tub front wall (6× M3 into inserts + flange bearing). A 5 g front-corner load on both sides "
  f"({2*Wf_corner*1.15*5:.0f} N) at ≈ 35 mm from the flange gives ≈ {2*Wf_corner*1.15*5*35/1000:.1f} N·m → ≈ "
  f"{2*Wf_corner*1.15*5*35/(2*25):.0f} N tension in the upper bolt pair, far below the ≈ 800 N pull-out of an M3 insert in PETG-CF.")
w("* Torsion is carried by the closed box formed by skid + tub walls + rails + upper deck (deck screwed at 8 points).\n")

# ---------------------------------------------------------------- electrical
w("## 4.6 Power budget and runtime\n")
loads = [("Jetson Orin Nano (MAXN Super, typical)", 15.0), ("Drive motors (2 × 0.9 A avg @ 11.1 V)", 20.0),
         ("Steering servo avg", 2.0), ("D435i", 2.0), ("RPLIDAR A1", 2.5), ("MCU, IMU, receiver, encoders", 1.0),
         ("DC-DC losses (~10 %)", 4.0)]
Ptot = sum(p for _, p in loads)
E = 11.1 * 5.0 * 0.8
w("| Load | Power (W) |\n|---|---:|")
for n, p in loads:
    w(f"| {n} | {p:.1f} |")
w(f"| **Total** | **{Ptot:.1f}** |\n")
w(f"Usable energy 3S 5000 mAh at 80 % DoD = {E:.1f} Wh → runtime ≈ **{E/Ptot*60:.0f} min** mixed driving; "
  f"≈ {E/(Ptot-20+2)*60:.0f} min parked (compute + sensors only).\n")
I_peak = 2 * stall_A * V_nom / 12 + 3.0 + 2.5
w(f"Peak current: 2 × stall {stall_A*V_nom/12:.1f} A + servo 3 A + electronics 2.5 A ≈ {I_peak:.0f} A → main fuse 15 A slow-blow, "
  "motor-branch fuse 10 A, compute branch 5 A. Wire: 14 AWG battery–fuse–E-stop, 18 AWG motor, 22–24 AWG signal.\n")

w("## 4.7 Design targets vs results\n")
w("| Requirement | Target | Result |\n|---|---|---|")
w(f"| Mass (incl. optional LiDAR) | ≤ 3.6 kg | {m_tot:.2f} kg |")
w(f"| Top speed | 1.5–2.5 m/s | {v_loaded:.2f} m/s |")
w(f"| Turning radius | ≤ 0.8 m | {R_rear_axle/1000:.2f} m |")
w(f"| Ground clearance | ≥ 25 mm under main tub | {M.groundClearance:.0f} mm tub, {M.frontSkidZ:.0f} mm front bulkhead (static). At full front "
  "compression the bulkhead underside is the bump stop, as on most 1/10 cars; fit 3 mm internal shock spacers if ground contact is unwanted |")
w(f"| Wheel travel | ≥ 25 mm | {M.suspensionTravel:.0f} mm |")
w(f"| Rollover threshold | ≥ 1.2 g | {M.frontTrack/2/cg[2]:.2f} g |")
w(f"| Runtime | ≥ 30 min | {E/Ptot*60:.0f} min |")
w(f"| Camera height | 120–200 mm | {M.cameraZ:.0f} mm |")

open(os.path.join(HERE, "..", "docs", "04_engineering_calculations.md"), "w").write("\n".join(out) + "\n")
json.dump(dict(mass=m_tot, cg=cg.tolist(), front_frac=front_frac, v_top=v_loaded, turn_radius=R_rear_axle,
               shock_front=fl, shock_rear=rl), open(os.path.join(HERE, "results.json"), "w"), indent=2)
print("\n".join(out))
